DL7AD/pecanpico9/tracker/software/doc/2fsk.jpg

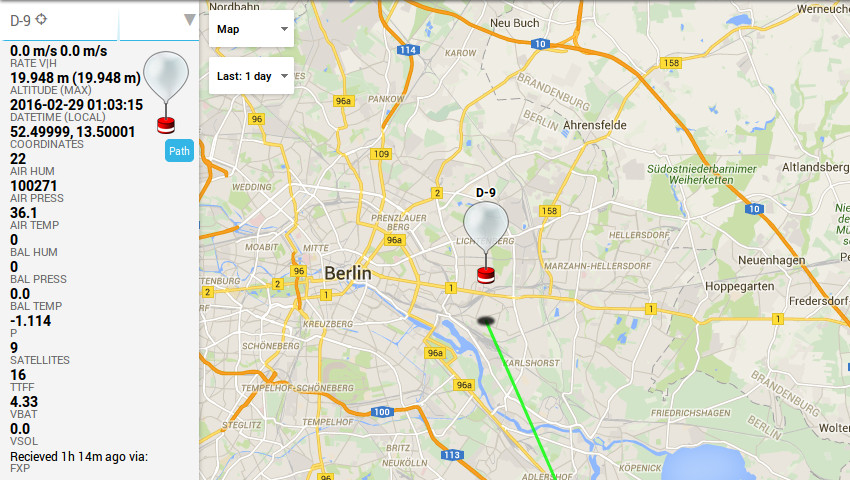
tracker/software/doc/2fsk.jpg
