DL7AD/pecanpico9/tracker/software/doc/aprs.jpg

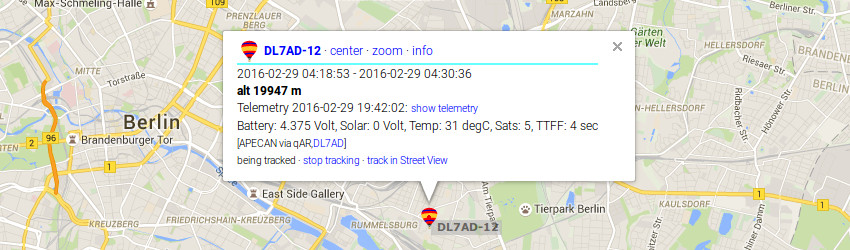
tracker/software/doc/aprs.jpg
