DL7AD/pecanpico9/tracker/software/doc/cw.jpg

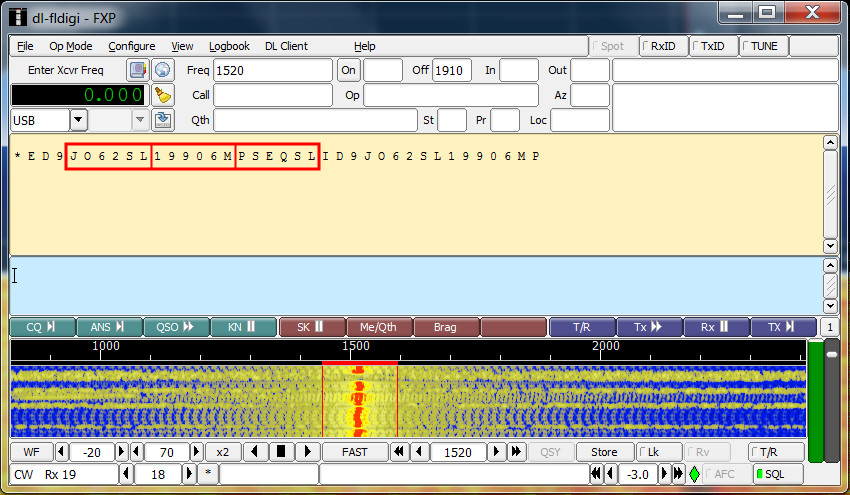
tracker/software/doc/cw.jpg
