DL7AD/pecanpico9/tracker/software/doc/programmer.jpg

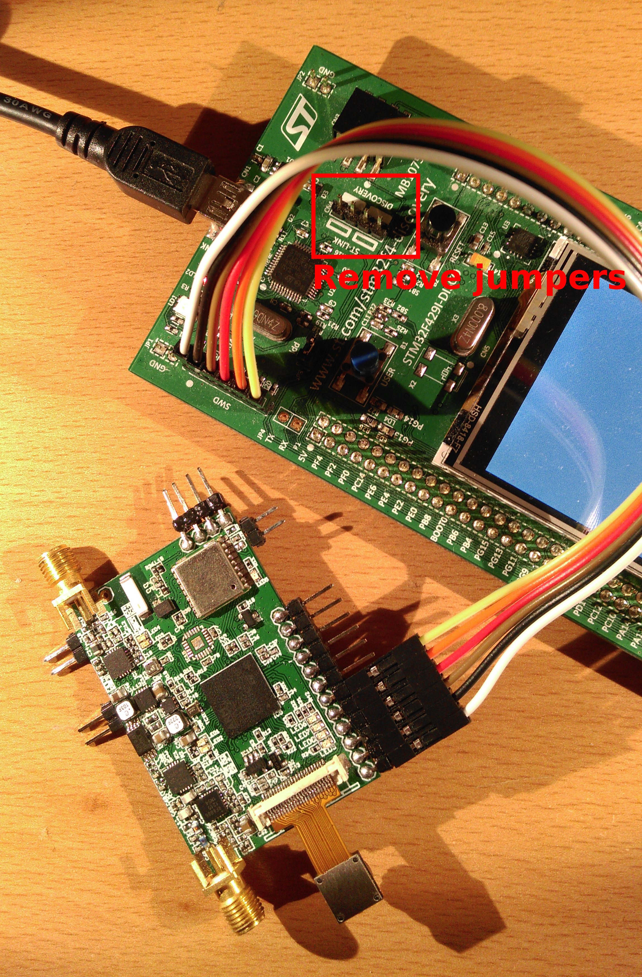
tracker/software/doc/programmer.jpg
