DL7AD/pecanpico9/tracker/software/doc/targets/pecanpico7a.jpg

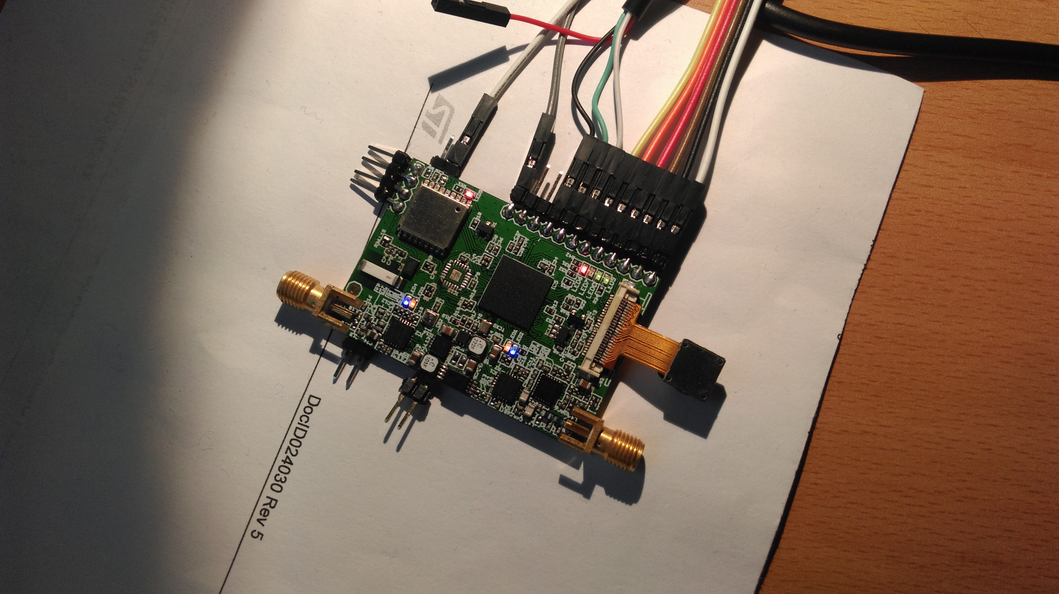
tracker/software/doc/targets/pecanpico7a.jpg
