DL7AD/pecanpico9/tracker/hardware/output/bom.ods

 |  |  |  |  |  |  | Prices roughly
Reference | Quantity | Package | Value | Specs | Mouser | Notes | Price | Price All
C48;C46;C45;C44;C43;C14;C30;C33;C20;C23;C29;C35 | 12 | C_0402 | 100n | 10V |  |  | 0.01 | 0.12
C32;C38 | 2 | C_0402 | 10n | 10V |  |  | 0.01 | 0.02
C40;C37;C39;C9;C8;C10;C11;C12;C13;C22;C51 | 11 | C_0402 | 2u2 | 10V |  |  | 0.03 | 0.33
R25;R26 | 2 | R_0402 | 4k7 | 1% |  |  | 0.01 | 0.02
R10;R11;R21;R35 | 4 | R_0402 | 1k5 | 1% |  |  | 0.01 | 0.04
D2 | 1 | LED_0603 | blue |  |  |  | 0.10 | 0.10
D3 | 1 | LED_0603 | green |  |  |  | 0.05 | 0.05
L2 | 1 | LPS3015 | LPS3015-222 |  | 994-LPS3015-222MRC |  | 1.03 | 1.03
R7 | 1 | R_0402 | 510k | 1% |  |  | 0.01 | 0.01
IC2 | 1 | DFN-6-1EP_2x2mm_Pitch0.65mm | TPS62260DRVR |  | 595-TPS62260DRVR |  | 1.35 | 1.35
R8;R36 | 2 | R_0402 | 249k | 1% |  |  | 0.01 | 0.02
C5;C26;C24 | 3 | C_0402 | 22p | 10V |  |  | 0.03 | 0.09
C6;C4;C3 | 3 | C_0805 | 10u | 10V |  |  | 0.10 | 0.30
X1 | 1 | tcxo | KT2016K26000BCW18ZAS |  | 581-KT2016K2BCW18ZAS |  | 1.77 | 1.77
IC1 | 1 | TSSOP-8_4.4x3mm_Pitch0.65mm | SPV1040T |  | 511-SPV1040T |  | 2.69 | 2.69
R3;R5;R33 | 3 | R_0402 | 22k | 1% |  |  | 0.01 | 0.03
R4;R6;R32 | 3 | R_0402 | 10k | 1% |  |  | 0.01 | 0.03
C2 | 1 | C_0402 | 1n | 16V |  |  | 0.01 | 0.01
R1 | 1 | R_0402 | 220k | 1% |  |  | 0.01 | 0.01
R2;R14;R24;R23;R17;R28;R31 | 7 | R_0402 | 100k | 1% |  |  | 0.01 | 0.07
L1 | 1 | XAL4040 | XAL4040-103 |  | 994-XAL4040-103MEC |  | 2.25 | 2.25
C1;C31 | 2 | C_0805 | 22u | 10V |  |  | 0.10 | 0.20
IC3 | 1 | QFN-16-1EP_3x3mm_Pitch0.5mm | ADP322ACPZ-115-R7 |  | 584-ADP322ACPZ-115R7 |  | 1.37 | 1.37
IC4 | 1 | QFN-20-1EP_4x4mm_Pitch0.5mm | Si4063-B1B-FM |  | 634-SI4063-B1B-FM |  | 2.01 | 2.01
C15;C16;C34 | 3 | C_0402 | 100p | 10V |  |  | 0.01 | 0.03
C18;C19;C25;C27 | 4 | C_0402 | 470p | 16V |  |  | 0.01 | 0.04
L3 | 1 | C_0805 | 470n |  | 994-0805LS-471XJLB |  | 1.35 | 1.35
P3 | 1 | USB_Micro-B_SMD | ZX62-B-5PA(33) |  | 798-ZX62-B-5PA33 |  | 0.58 | 0.58
IC6 | 1 | EVA7M | EVA-7M |  |  | get from uBlox directly | 15.00 | 15.00
R19;R20;R13 | 3 | R_0402 | N/A |  |  | do not assemble | 0.01 | 0.03
D7 | 1 | LED_0603 | red |  |  |  | 0.05 | 0.05
R22;R18 | 2 | R_0603 | 0R1 |  | 667-ERJ-3RSFR10V |  | 0.01 | 0.02
IC7 | 1 | DFN-10-1EP_3x3mm_Pitch0.5mm | PAC1720-1-AIA-TR |  | 579-PAC1720-1-AIA-TR |  | 1.63 | 1.63
R27 | 1 | R_0402 | 0R |  |  |  | 0.01 | 0.01
P4;P6 | 2 | IPX_2mm | IPX 2mm |  | 960-RECE20279001E01 |  | 0.87 | 1.74
D9;D8 | 2 | RFN1L7S | RFN1L7STE25 |  | 755-RFN1L7STE25 |  | 0.31 | 0.62
R29;R30 | 2 | R_0402 | 1k | 1% |  |  | 0.01 | 0.02
C28 | 1 | C_0402 | 1u | 10V |  |  | 0.02 | 0.02
Q1 | 1 | SOT-23 | FDN306P |  | 512-FDN306P |  | 0.37 | 0.37
W8;W6;W10 | 3 | PAD_6x3 | Pad |  |  | do not assemble | 0.00 | 0.00
W7;W11 | 2 | PAD_3x3 | Pad |  |  | do not assemble | 0.00 | 0.00
P5 | 1 | Pin_Header_Straight_1x02_SMD | CONN_01X02 |  |  | do not assemble | 0.00 | 0.00
L4;L6 | 2 | C_0805 | 56n |  | 994-0805CS-560XJLC |  | 0.94 | 1.88
IC9 | 1 | BME280 | BME280 |  | 262-BME280 |  | 6.53 | 6.53
L5 | 1 | C_0805 | 82n |  | 994-0805CS-820XJLC |  | 0.94 | 0.94
W1;W2;W3;W9 | 4 | PAD_3x1.5 | Testpad |  |  | do not assemble | 0.00 | 0.00
IC8 | 1 | DFN-6-1EP_2x2mm_Pitch0.5mm | LDLN015PU33R |  | 511-LDLN015PU33R |  | 1.25 | 1.25
IC5 | 1 | LQFP-64_10x10mm_Pitch0.5mm | STM32F413xG |  | 511-STM32F413RGT6 |  | 8.75 | 8.75
P2 | 1 | Pin_Header_Straight_1x10 | CONN_01X10 |  |  | do not assemble | 0.00 | 0.00
P1 | 1 | FFC1x24_0.5mm (+camera) | CONN_01X25 |  |  |  | 6.00 | 6.00
W5;W4 | 2 | Testpad | Testpad |  |  | do not assemble | 0.00 | 0.00
PCB | 1 |  |  |  |  |  | 3.00 | 3.00
Assembly | 1 |  |  |  |  |  | 20.00 | 20.00
 |  |  |  |  |  |  |  | 83.78
