DL7AD/pecanpico9/tracker/software/doc/sample_pictures/test1.jpg

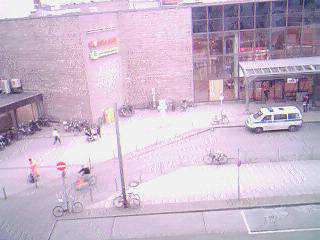
tracker/software/doc/sample_pictures/test1.jpg
