DL7AD/pecanpico9/tracker/software/doc/sample_pictures/test3.jpg

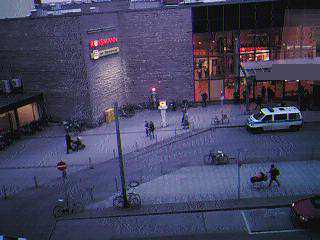
tracker/software/doc/sample_pictures/test3.jpg
