DL7AD/pecanpico9/tracker/software/doc/sample_pictures/test4.jpg

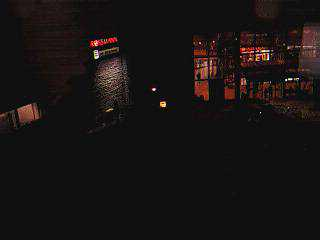
tracker/software/doc/sample_pictures/test4.jpg
