DL7AD/pecanpico9/tracker/hardware/pecanpico9.kicad_pcb

## KiCad design tracker/hardware/pecanpico9.kicad_pcb (2017-06-15)

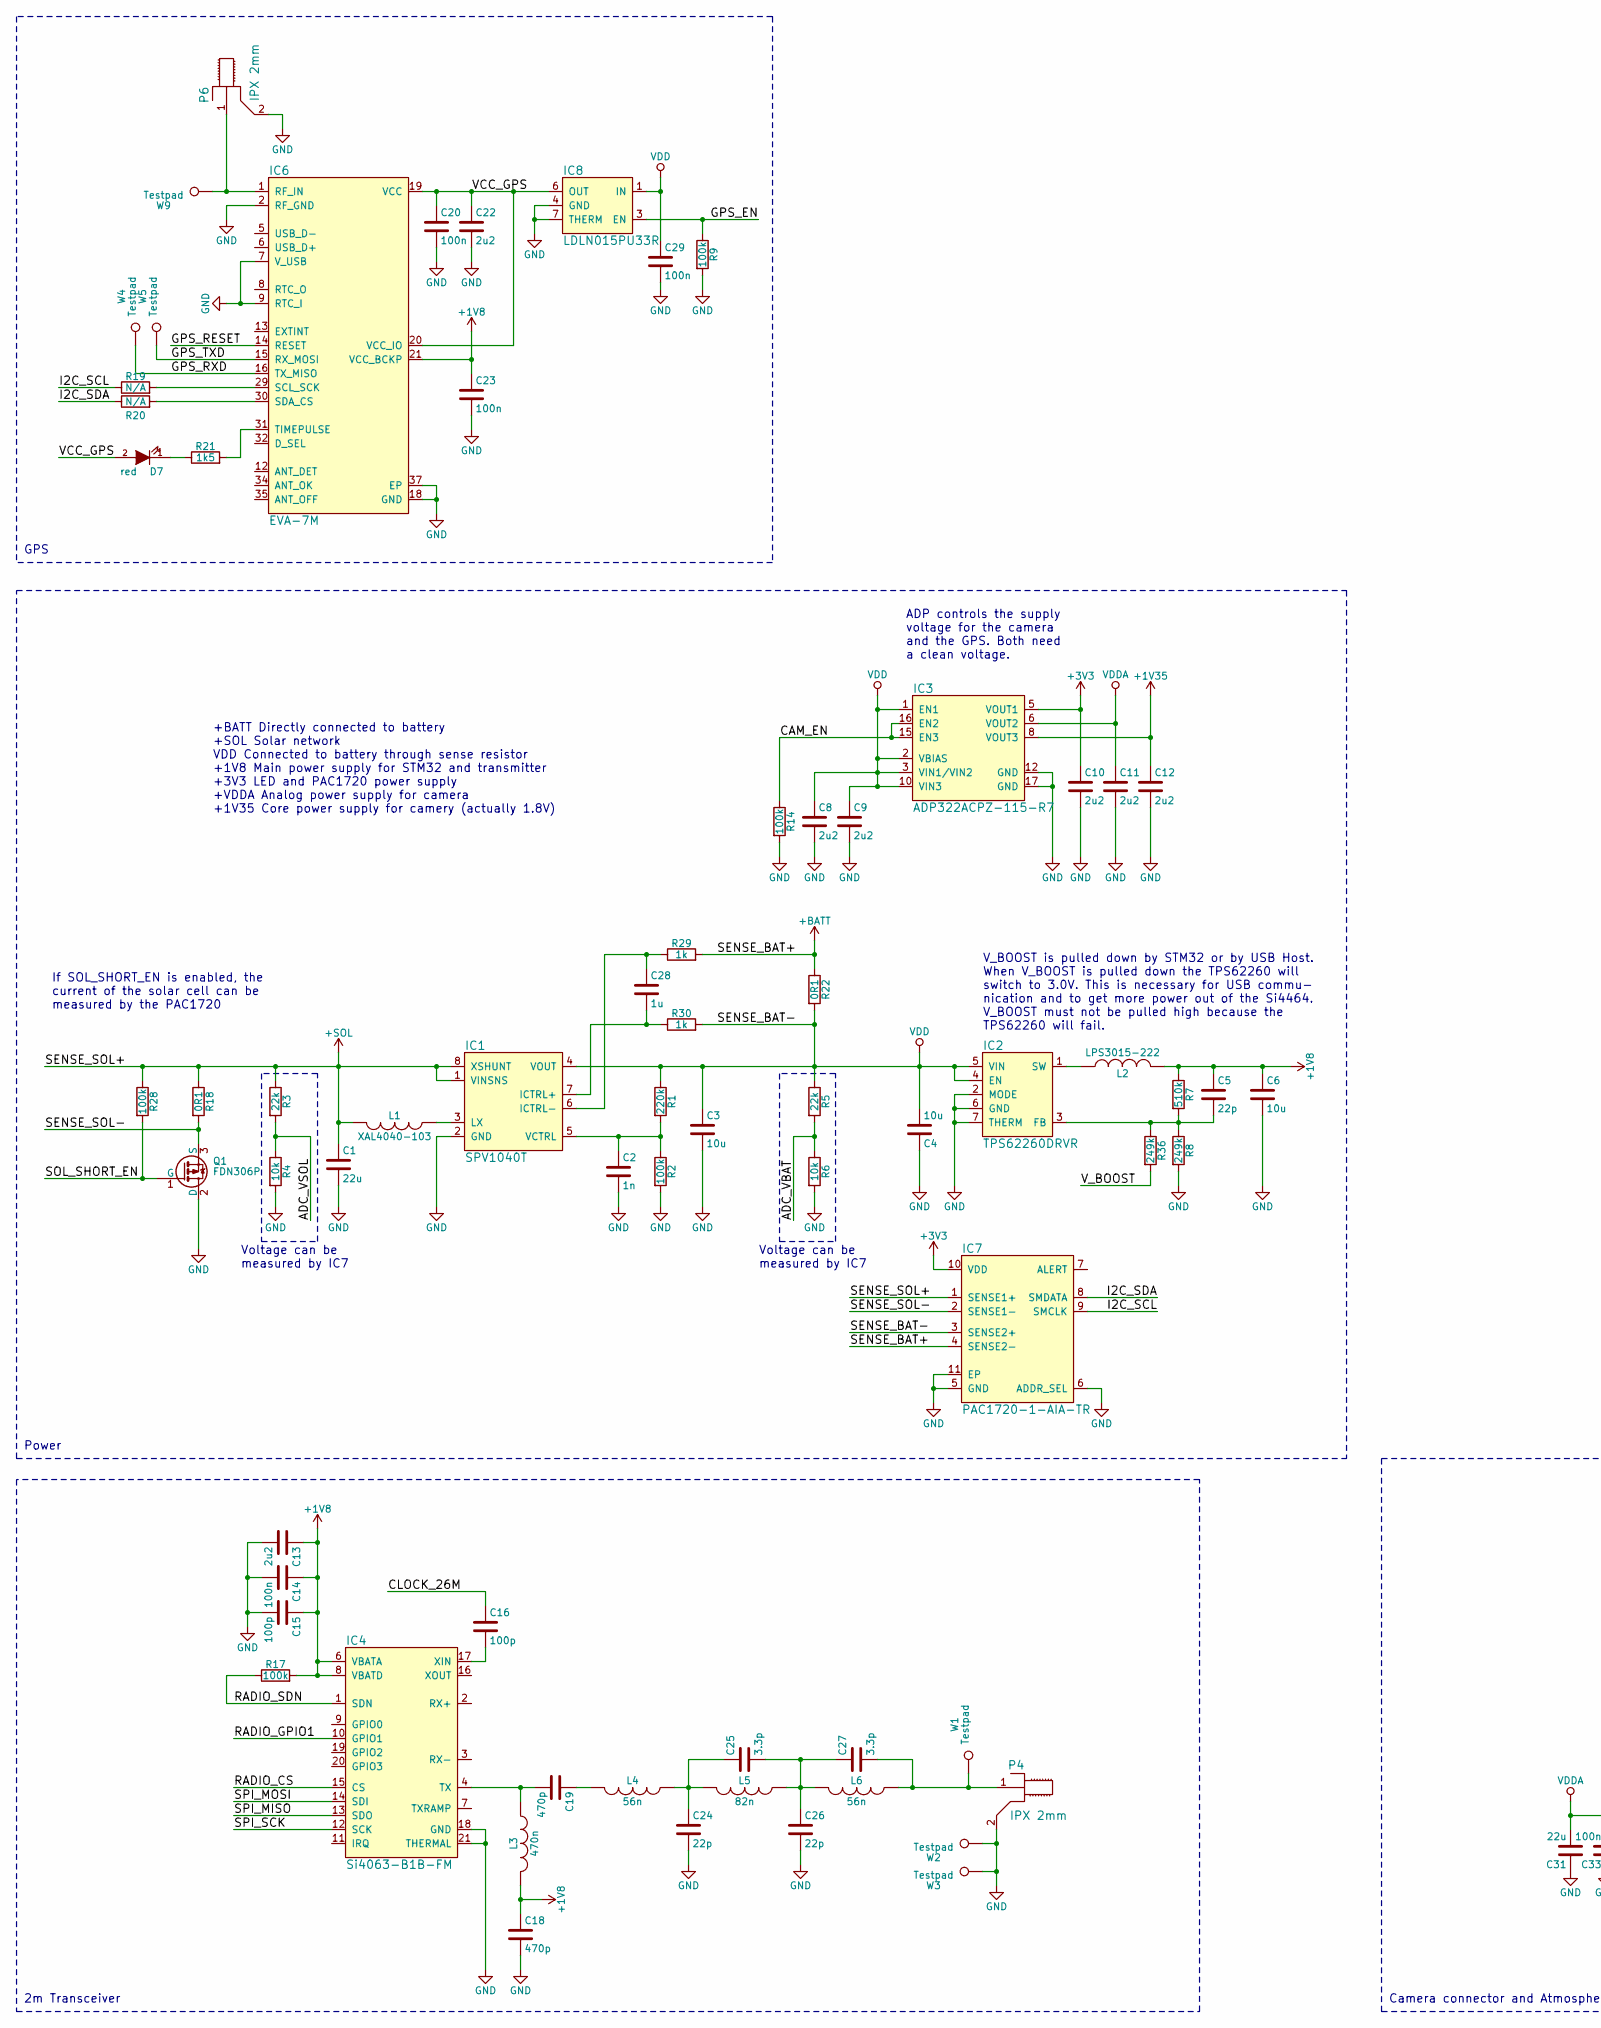
[picture p30: schematic pecanpico9.sch, Pecan Pico 9a, part in row 1, column 1]

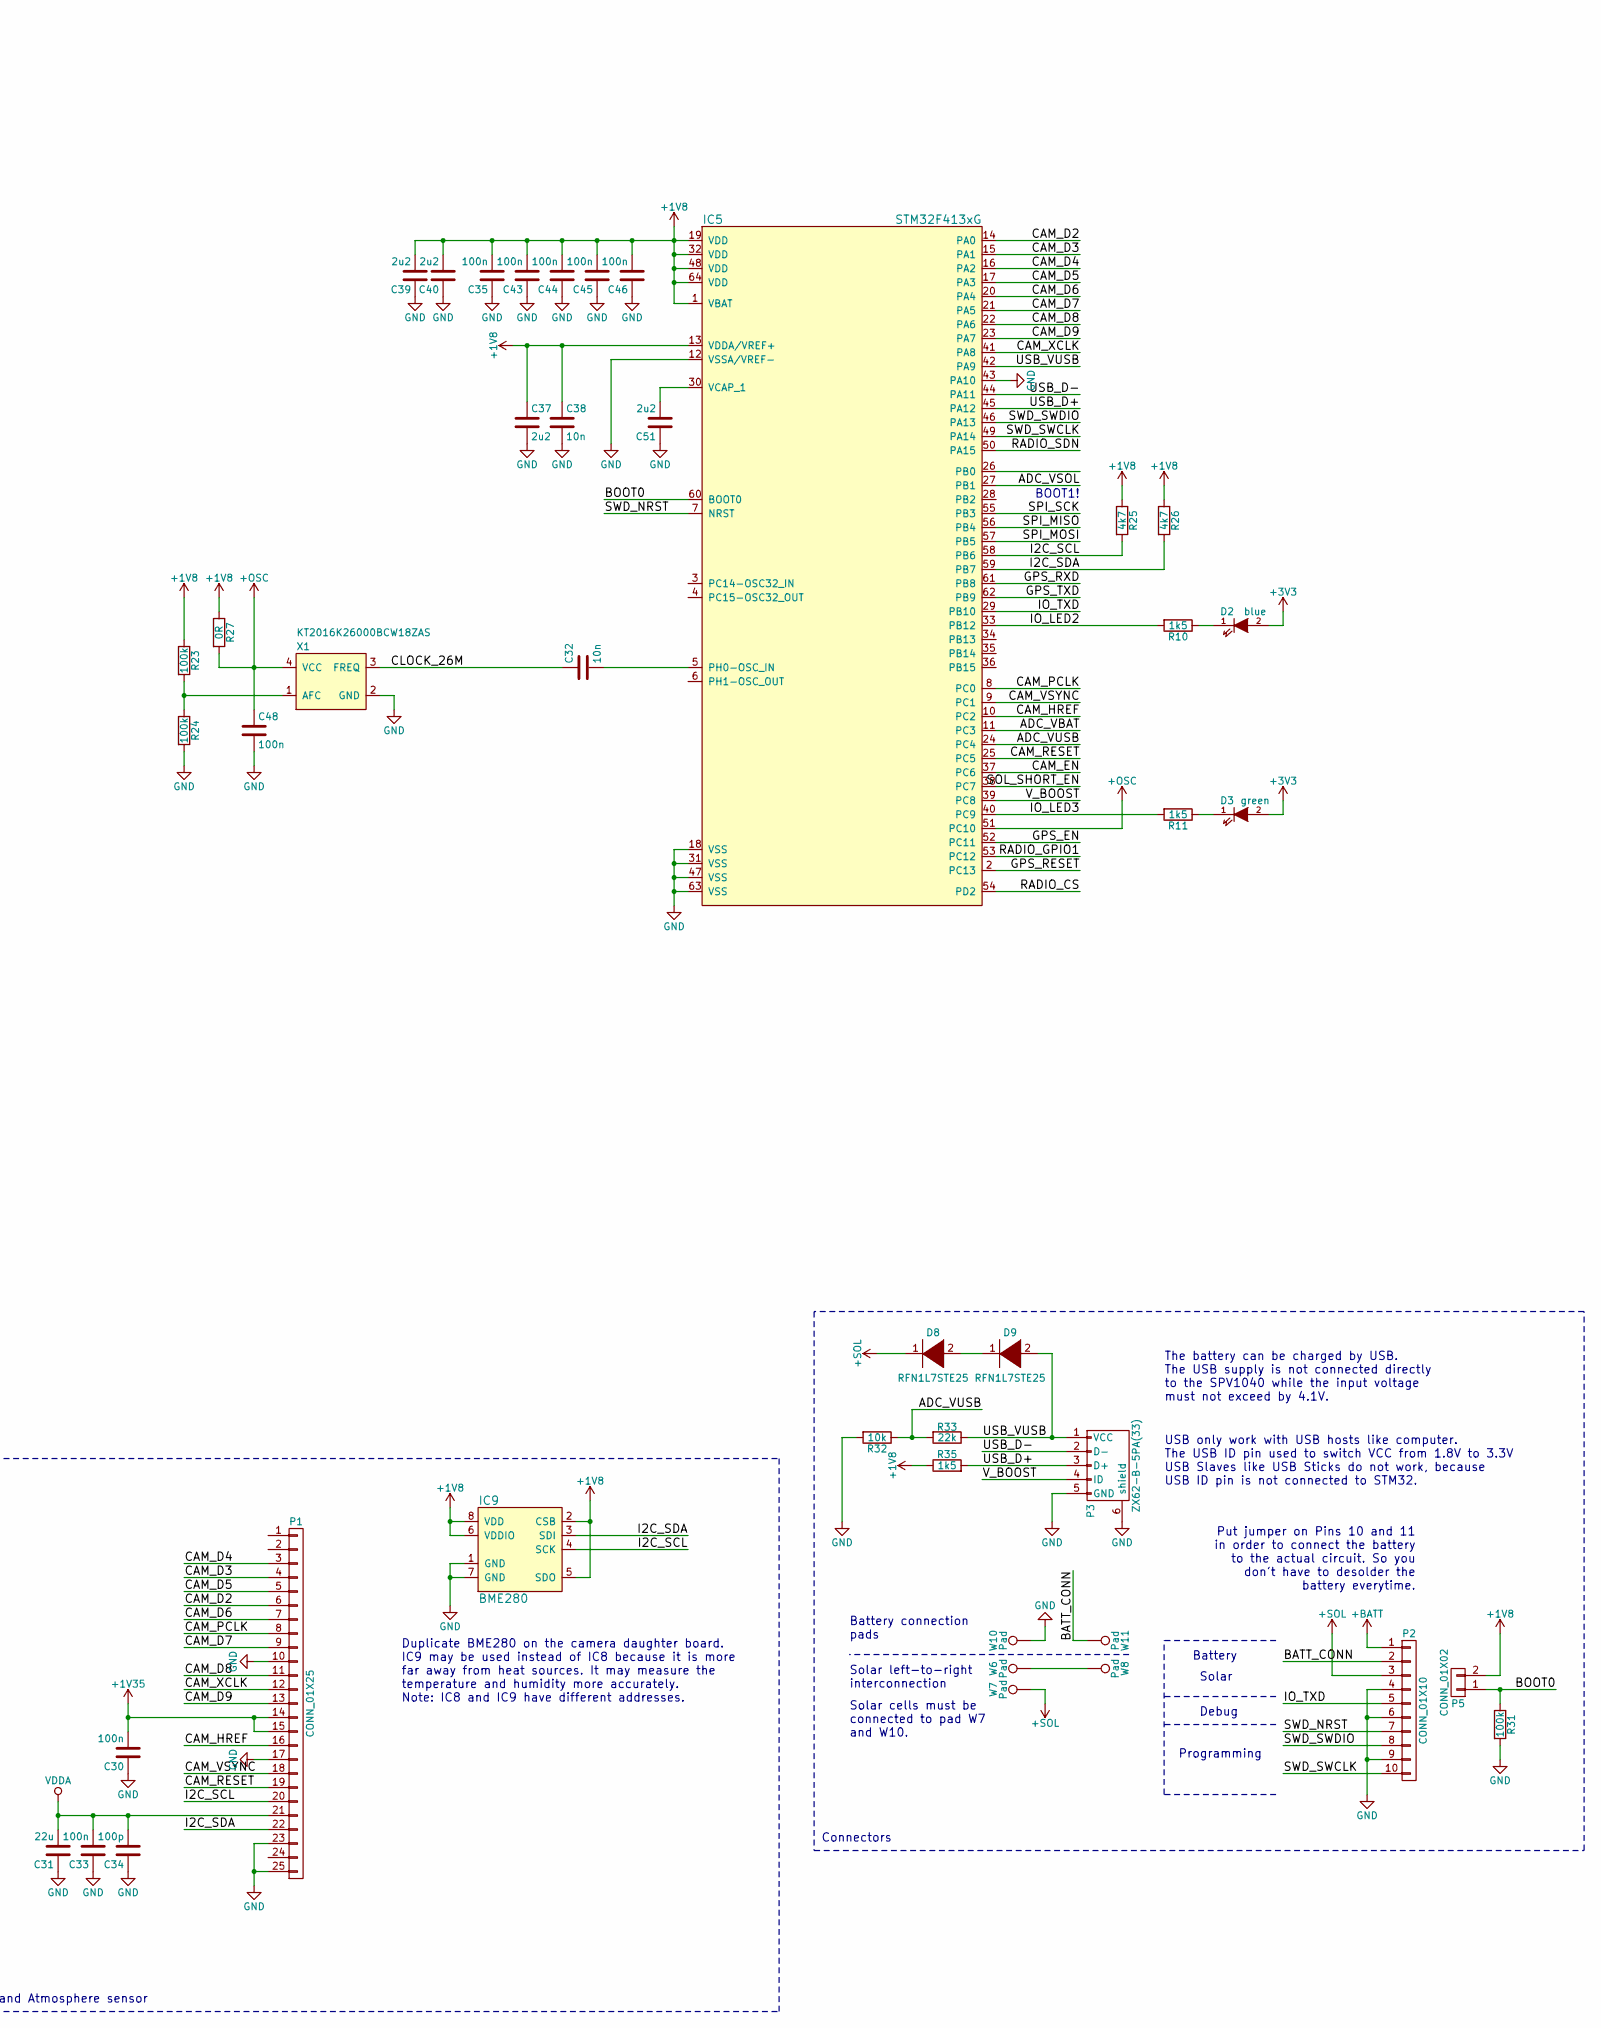
[picture p31: schematic pecanpico9.sch, Pecan Pico 9a, part in row 1, column 2]

Parts:
C1, C31: 22u; C_0805
C2: 1n; C_0402
C3, C4, C6: 10u; C_0805
C5, C24, C26: 22p; C_0402
C8, C9, C10, C11, C12, C13, C22, C37, C39, C40, C51: 2u2; C_0402
C14, C20, C23, C29, C30, C33, C35, C43, C44, C45, C46, C48: 100n; C_0402
C15, C16, C34: 100p; C_0402
C18, C19: 470p; C_0402
C25, C27: 3.3p; C_0402
C28: 1u; C_0402
C32, C38: 10n; C_0402
D2: blue; LED_0603
D3: green; LED_0603
D7: red; LED_0603
D8, D9: RFN1L7STE25; RFN1L7S; Mouser 755-RFN1L7STE25
IC1: SPV1040T; TSSOP-8_4.4x3mm_Pitch0.65mm; Mouser 511-SPV1040T
IC2: TPS62260DRVR; DFN-6-1EP_2x2mm_Pitch0.65mm; Mouser 595-TPS62260DRVR
IC3: ADP322ACPZ-115-R7; QFN-16-1EP_3x3mm_Pitch0.5mm; Mouser 584-ADP322ACPZ-115R7
IC4: Si4063-B1B-FM; QFN-20-1EP_4x4mm_Pitch0.5mm; Mouser 634-SI4063-B1B-FM
IC5: STM32F413xG; LQFP-64_10x10mm_Pitch0.5mm
IC6: EVA-7M; EVA7M
IC7: PAC1720-1-AIA-TR; DFN-10-1EP_3x3mm_Pitch0.5mm; Mouser 579-PAC1720-1-AIA-TR
IC8: LDLN015PU33R; DFN-6-1EP_2x2mm_Pitch0.5mm; Mouser 511-LDLN015PU33R
IC9: BME280; Mouser 262-BME280
L1: XAL4040-103; XAL4040; Mouser 994-XAL4040-103MEC
L2: LPS3015-222; LPS3015; Mouser 994-LPS3015-222MRC
L3: 470n; C_0805; Mouser 994-0805LS-471XJLB
L4, L6: 56n; C_0805; Mouser 994-0805CS-560XJLC
L5: 82n; C_0805; Mouser 994-0805CS-820XJLC
P1: CONN_01X25; FFC1x24_0.5mm
P2: CONN_01X10; Pin_Header_Straight_1x10
P3: ZX62-B-5PA(33); USB_Micro-B_SMD; Mouser 798-ZX62-B-5PA33
P4, P6: IPX 2mm; IPX_2mm; Mouser 960-RECE20279001E01
P5: CONN_01X02; Pin_Header_Straight_1x02_SMD
Q1: FDN306P; SOT-23; Mouser 512-FDN306P
R1: 220k; R_0402
R2, R9, R14, R17, R23, R24, R28, R31: 100k; R_0402
R3, R5, R33: 22k; R_0402
R4, R6, R32: 10k; R_0402
R7: 510k; R_0402
R8, R36: 249k; R_0402
R10, R11, R21, R35: 1k5; R_0402
R18, R22: 0R1; R_0603; Mouser 667-ERJ-3RSFR10V
R19, R20: N/A; R_0402
R25, R26: 4k7; R_0402
R27: 0R; R_0402
R29, R30: 1k; R_0402
W1, W2, W3, W9: Testpad; PAD_3x1.5
W4, W5: Testpad
W6, W8, W10: Pad; PAD_6x3
W7, W11: Pad; PAD_3x3
X1: KT2016K26000BCW18ZAS; tcxo; Mouser 581-KT2016K2BCW18ZAS

Connections:
+1V8: C5.1, C6.1, C13.1, C14.1, C15.1, C18.1, C23.1, C35.2, C37.1, C38.1, C39.2, C40.2, C43.2, C44.2, C45.2, C46.2, IC4.6 (VBATA), IC4.8 (VBATD), IC5.1 (VBAT), IC5.13 (VDDA/VREF+), IC5.19 (VDD), IC5.32 (VDD), IC5.48 (VDD), IC5.64 (VDD), IC6.21 (VCC_BCKP), IC9.2 (CSB), IC9.5 (SDO), IC9.6 (VDDIO), IC9.8 (VDD), L2.2, L3.2, P5.2, R7.1, R17.2, R23.1, R25.1, R26.1, R27.1, R35.1
+1V35: C12.1, C30.2, IC3.8 (VOUT3), P1.14, P1.15
+3V3: C10.1, D2.2 (A), D3.2 (A), IC3.5 (VOUT1), IC7.10 (VDD)
+BATT: IC7.4 (SENSE2-), P2.1, R22.1, R29.2
+OSC: C48.1, IC5.51 (PC10), R27.2, X1.4 (VCC)
+SOL: C1.1, D8.1 (K), IC1.1 (VINSNS), IC1.8 (XSHUNT), IC7.1 (SENSE1+), L1.2, P2.3, R3.1, R18.1, R28.1, W7.1
/ADC_VBAT: IC5.11 (PC3), R5.2, R6.1
/ADC_VSOL: IC5.27 (PB1), R3.2, R4.1
/ADC_VUSB: IC5.24 (PC4), R32.1, R33.2
/BATT_CONN: P2.2, W11.1
/BOOT0: IC5.60 (BOOT0), P5.1, R31.1
/CAM_D2: IC5.14 (PA0), P1.6
/CAM_D3: IC5.15 (PA1), P1.4
/CAM_D4: IC5.16 (PA2), P1.3
/CAM_D5: IC5.17 (PA3), P1.5
/CAM_D6: IC5.20 (PA4), P1.7
/CAM_D7: IC5.21 (PA5), P1.9
/CAM_D8: IC5.22 (PA6), P1.11
/CAM_D9: IC5.23 (PA7), P1.13
/CAM_EN: IC3.15 (EN3), IC3.16 (EN2), IC5.37 (PC6), R14.1
/CAM_HREF: IC5.10 (PC2), P1.16
/CAM_PCLK: IC5.8 (PC0), P1.8
/CAM_RESET: IC5.25 (PC5), P1.19
/CAM_VSYNC: IC5.9 (PC1), P1.18
/CAM_XCLK: IC5.41 (PA8), P1.12
/CLOCK_26M: C16.1, C32.1, X1.3 (FREQ)
/GPS_EN: IC5.52 (PC11), IC8.3 (EN), R9.1
/GPS_RESET: IC5.2 (PC13), IC6.14 (RESET)
/GPS_RXD: IC5.61 (PB8), IC6.16 (TX_MISO), W4.1
/GPS_TXD: IC5.62 (PB9), IC6.15 (RX_MOSI), W5.1
/I2C_SCL: IC5.58 (PB6), IC7.9 (SMCLK), IC9.4 (SCK), P1.20, R19.1, R25.2
/I2C_SDA: IC5.59 (PB7), IC7.8 (SMDATA), IC9.3 (SDI), P1.22, R20.1, R26.2
/IO_LED2: IC5.33 (PB12), R10.2
/IO_LED3: IC5.40 (PC9), R11.2
/IO_TXD: IC5.29 (PB10), P2.5
/RADIO_CS: IC4.15 (CS), IC5.54 (PD2)
/RADIO_GPIO1: IC4.10 (GPIO1), IC5.53 (PC12)
/RADIO_SDN: IC4.1 (SDN), IC5.50 (PA15), R17.1
/SENSE_SOL-: IC7.2 (SENSE1-), Q1.3 (S), R18.2
/SOL_SHORT_EN: IC5.38 (PC7), Q1.1 (G), R28.2
/SPI_MISO: IC4.13 (SDO), IC5.56 (PB4)
/SPI_MOSI: IC4.14 (SDI), IC5.57 (PB5)
/SPI_SCK: IC4.12 (SCK), IC5.55 (PB3)
/SWD_NRST: IC5.7 (NRST), P2.7
/SWD_SWCLK: IC5.49 (PA14), P2.10
/SWD_SWDIO: IC5.46 (PA13), P2.8
/USB_D+: IC5.45 (PA12), P3.3 (D+), R35.2
/USB_D-: IC5.44 (PA11), P3.2 (D-)
/USB_VUSB: D9.2 (A), IC5.42 (PA9), P3.1 (VCC), R33.1
/VCC_GPS: C20.1, C22.1, D7.2 (A), IC6.19 (VCC), IC6.20 (VCC_IO), IC8.6 (OUT)
/V_BOOST: IC5.39 (PC8), P3.4 (ID), R36.2
GND: C1.2, C2.2, C3.2, C4.1, C6.2, C8.2, C9.2, C10.2, C11.2, C12.2, C13.2, C14.2, C15.2, C18.2, C20.2, C22.2, C23.2, C24.2, C26.2, C29.2, C30.1, C31.1, C33.1, C34.1, C35.1, C37.2, C38.2, C39.1, C40.1, C43.1, C44.1, C45.1, C46.1, C48.2, C51.1, IC1.2 (GND), IC2.2 (MODE), IC2.6 (GND), IC2.7 (THERM), IC3.12 (GND), IC3.17 (GND), IC4.18 (GND), IC4.21 (THERMAL), IC5.12 (VSSA/VREF-), IC5.18 (VSS), IC5.31 (VSS), IC5.43 (PA10), IC5.47 (VSS), IC5.63 (VSS), IC6.2 (RF_GND), IC6.7 (V_USB), IC6.9 (RTC_I), IC6.18 (GND), IC6.37 (EP), IC7.5 (GND), IC7.6 (ADDR_SEL), IC7.11 (EP), IC8.4 (GND), IC8.7 (THERM), IC9.1 (GND), IC9.7 (GND), P1.10, P1.17, P1.23, P1.25, P2.4, P2.6, P2.9, P3.5 (GND), P3.6 (shield), P4.2, P6.2, Q1.2 (D), R2.2, R4.2, R6.2, R8.2, R9.2, R14.2, R24.2, R31.2, R32.2, W2.1, W3.1, W10.1, X1.2 (GND)
unnamed: C2.1, IC1.5 (VCTRL), R1.2, R2.1
unnamed: C5.2, IC2.3 (FB), R7.2, R8.1, R36.1
unnamed: C16.2, IC4.17 (XIN)
unnamed: C19.1, L4.2
unnamed: C19.2, IC4.4 (TX), L3.1
unnamed: C24.1, C25.1, L4.1, L5.2
unnamed: C25.2, C26.1, C27.1, L5.1, L6.2
unnamed: C27.2, L6.1, P4.1, W1.1
unnamed: C28.1, IC1.6 (ICTRL-), R29.1
unnamed: C28.2, IC1.7 (ICTRL+), R30.1
unnamed: C32.2, IC5.5 (PH0-OSC_IN)
unnamed: C51.2, IC5.30 (VCAP_1)
unnamed: D2.1 (K), R10.1
unnamed: D3.1 (K), R11.1
unnamed: D7.1 (K), R21.1
unnamed: D8.2 (A), D9.1 (K)
unnamed: IC1.3 (LX), L1.1
unnamed: IC2.1 (SW), L2.1
unnamed: IC6.1 (RF_IN), P6.1, W9.1
unnamed: IC6.29 (SCL_SCK), R19.2
unnamed: IC6.30 (SDA_CS), R20.2
unnamed: IC6.31 (TIMEPULSE), R21.2
unnamed: R23.2, R24.1, X1.1 (AFC)
unnamed: W6.1, W8.1
VDD: C3.1, C4.2, C8.1, C9.1, C29.1, IC1.4 (VOUT), IC2.4 (EN), IC2.5 (VIN), IC3.1 (EN1), IC3.2 (VBIAS), IC3.3 (VIN1/VIN2), IC3.10 (VIN3), IC7.3 (SENSE2+), IC8.1 (IN), R1.1, R5.1, R22.2, R30.2
VDDA: C11.1, C31.2, C33.2, C34.2, IC3.6 (VOUT2), P1.21

Notes on the sheet:
USB only work with USB hosts like computer. The USB ID pin used to switch VCC from 1.8V to 3.3V USB Slaves like USB Sticks do not work, because USB ID pin is not connected to STM32.
Voltage can be measured by IC7
Duplicate BME280 on the camera daughter board. IC9 may be used instead of IC8 because it is more far away from heat sources. It may measure the temperature and humidity more accurately. Note: IC8 and IC9 have different addresses.
V_BOOST is pulled down by STM32 or by USB Host. When V_BOOST is pulled down the TPS62260 will switch to 3.0V. This is necessary for USB commu- nication and to get more power out of the Si4464. V_BOOST must not be pulled high because the TPS62260 will fail.
ADP controls the supply voltage for the camera and the GPS. Both need a clean voltage.
Put jumper on Pins 10 and 11 in order to connect the battery to the actual circuit. So you don't have to desolder the battery everytime.
Battery
Solar
Debug
Programming
Battery connection pads
Solar left-to-right interconnection
Solar cells must be connected to pad W7 and W10.
The battery can be charged by USB. The USB supply is not connected directly to the SPV1040 while the input voltage must not exceed by 4.1V.
Camera connector and Atmosphere sensor
2m Transceiver
Power
GPS
Connectors
+BATT Directly connected to battery +SOL Solar network VDD Connected to battery through sense resistor +1V8 Main power supply for STM32 and transmitter +3V3 LED and PAC1720 power supply +VDDA Analog power supply for camera +1V35 Core power supply for camery (actually 1.8V)
If SOL_SHORT_EN is enabled, the current of the solar cell can be measured by the PAC1720
BOOT1!

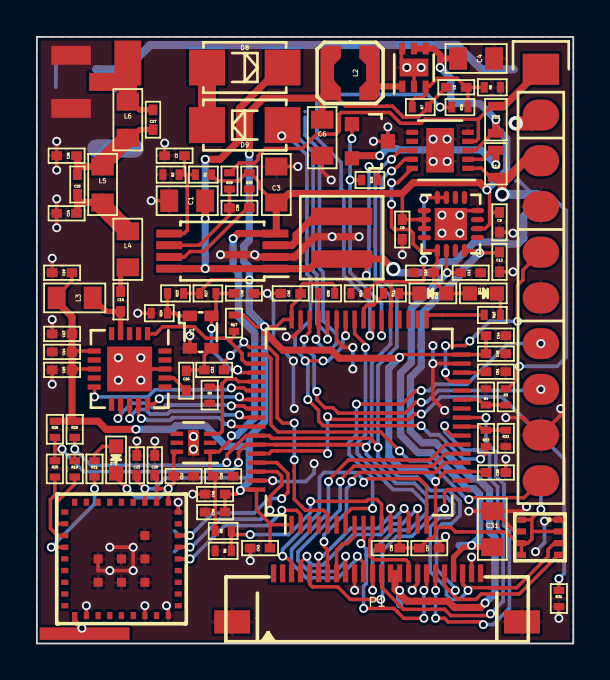
[picture p32: board pecanpico9.kicad_pcb from above]

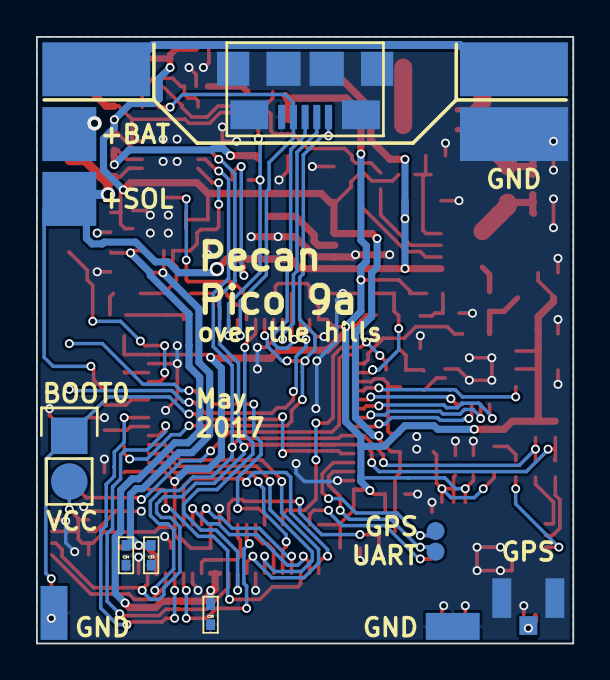
[picture p33: board pecanpico9.kicad_pcb from below]

Board: 2 copper layers, 29.8 x 33.7 mm, 112 parts (15 on the bottom side), 78 nets.
