DL7AD/pecanpico9/tracker/software/board/board.h

/*
    ChibiOS - Copyright (C) 2006..2016 Giovanni Di Sirio

    Licensed under the Apache License, Version 2.0 (the "License");
    you may not use this file except in compliance with the License.
    You may obtain a copy of the License at

        http://www.apache.org/licenses/LICENSE-2.0

    Unless required by applicable law or agreed to in writing, software
    distributed under the License is distributed on an "AS IS" BASIS,
    WITHOUT WARRANTIES OR CONDITIONS OF ANY KIND, either express or implied.
    See the License for the specific language governing permissions and
    limitations under the License.
*/

#ifndef _BOARD_H_
#define _BOARD_H_

/*
 * Setup for Pecan Pico 9a board.
 */

/*
 * Board identifier.
 */
#define BOARD_PECANPICO9A
#define BOARD_NAME                  "Pecan Pico 9a"

/*
 * No LSE available
 */
#if !defined(STM32_LSECLK)
#define STM32_LSECLK                0U
#endif

#if !defined(STM32_HSECLK)
#define STM32_HSECLK                26000000U
#endif

/*
 * Board voltages
 * Required for performance limits calculation
 */
#define STM32_VDD                   180U

/*
 * MCU type as defined in the ST header
 */
#define STM32F413xx

/*
 * Radio specifications
 */
#define RADIO_MIN_FREQ				144000000
#define RADIO_MAX_FREQ				148000000
#define RADIO_CLK					STM32_HSECLK

/*
 * IO pins assignments.
 */
#define GPIOA_PIN0                  0U
#define GPIOA_PIN1                  1U
#define GPIOA_PIN2                  2U
#define GPIOA_PIN3                  3U
#define GPIOA_PIN4                  4U
#define GPIOA_PIN5                  5U
#define GPIOA_PIN6                  6U
#define GPIOA_PIN7                  7U
#define GPIOA_PIN8                  8U
#define GPIOA_USB_VBUS              9U
#define GPIOA_USB_ID                10U
#define GPIOA_USB_DM                11U
#define GPIOA_USB_DP                12U
#define GPIOA_SWDIO                 13U
#define GPIOA_SWCLK                 14U
#define GPIOA_PIN15                 15U

#define GPIOB_PIN0                  0U
#define GPIOB_PIN1                  1U
#define GPIOB_PIN2                  2U
#define GPIOB_PIN3                  3U
#define GPIOB_PIN4                  4U
#define GPIOB_PIN5                  5U
#define GPIOB_PIN6                  6U
#define GPIOB_PIN7                  7U
#define GPIOB_PIN8                  8U
#define GPIOB_PIN9                  9U
#define GPIOB_PIN10                 10U
#define GPIOB_PIN11                 11U
#define GPIOB_PIN12                 12U
#define GPIOB_PIN13                 13U
#define GPIOB_PIN14                 14U
#define GPIOB_PIN15                 15U

#define GPIOC_PIN0                  0U
#define GPIOC_PIN1                  1U
#define GPIOC_PIN2                  2U
#define GPIOC_PIN3                  3U
#define GPIOC_PIN4                  4U
#define GPIOC_PIN5                  5U
#define GPIOC_PIN6                  6U
#define GPIOC_PIN7                  7U
#define GPIOC_PIN8                  8U
#define GPIOC_PIN9                  9U
#define GPIOC_PIN10                 10U
#define GPIOC_PIN11                 11U
#define GPIOC_PIN12                 12U
#define GPIOC_PIN13                 13U
#define GPIOC_OSC32_IN              14U
#define GPIOC_OSC32_OUT             15U

#define GPIOD_PIN0                  0U
#define GPIOD_PIN1                  1U
#define GPIOD_PIN2                  2U
#define GPIOD_PIN3                  3U
#define GPIOD_PIN4                  4U
#define GPIOD_PIN5                  5U
#define GPIOD_PIN6                  6U
#define GPIOD_PIN7                  7U
#define GPIOD_PIN8                  8U
#define GPIOD_PIN9                  9U
#define GPIOD_PIN10                 10U
#define GPIOD_PIN11                 11U
#define GPIOD_PIN12                 12U
#define GPIOD_PIN13                 13U
#define GPIOD_PIN14                 14U
#define GPIOD_PIN15                 15U

#define GPIOE_PIN0                  0U
#define GPIOE_PIN1                  1U
#define GPIOE_PIN2                  2U
#define GPIOE_PIN3                  3U
#define GPIOE_PIN4                  4U
#define GPIOE_PIN5                  5U
#define GPIOE_PIN6                  6U
#define GPIOE_PIN7                  7U
#define GPIOE_PIN8                  8U
#define GPIOE_PIN9                  9U
#define GPIOE_PIN10                 10U
#define GPIOE_PIN11                 11U
#define GPIOE_PIN12                 12U
#define GPIOE_PIN13                 13U
#define GPIOE_PIN14                 14U
#define GPIOE_PIN15                 15U

#define GPIOF_PIN0                  0U
#define GPIOF_PIN1                  1U
#define GPIOF_PIN2                  2U
#define GPIOF_PIN3                  3U
#define GPIOF_PIN4                  4U
#define GPIOF_PIN5                  5U
#define GPIOF_PIN6                  6U
#define GPIOF_PIN7                  7U
#define GPIOF_PIN8                  8U
#define GPIOF_PIN9                  9U
#define GPIOF_PIN10                 10U
#define GPIOF_PIN11                 11U
#define GPIOF_PIN12                 12U
#define GPIOF_PIN13                 13U
#define GPIOF_PIN14                 14U
#define GPIOF_PIN15                 15U

#define GPIOG_PIN0                  0U
#define GPIOG_PIN1                  1U
#define GPIOG_PIN2                  2U
#define GPIOG_PIN3                  3U
#define GPIOG_PIN4                  4U
#define GPIOG_PIN5                  5U
#define GPIOG_PIN6                  6U
#define GPIOG_PIN7                  7U
#define GPIOG_PIN8                  8U
#define GPIOG_PIN9                  9U
#define GPIOG_PIN10                 10U
#define GPIOG_PIN11                 11U
#define GPIOG_PIN12                 12U
#define GPIOG_PIN13                 13U
#define GPIOG_PIN14                 14U
#define GPIOG_PIN15                 15U

#define GPIOH_OSC_IN                0U
#define GPIOH_OSC_OUT               1U
#define GPIOH_PIN2                  2U
#define GPIOH_PIN3                  3U
#define GPIOH_PIN4                  4U
#define GPIOH_PIN5                  5U
#define GPIOH_PIN6                  6U
#define GPIOH_PIN7                  7U
#define GPIOH_PIN8                  8U
#define GPIOH_PIN9                  9U
#define GPIOH_PIN10                 10U
#define GPIOH_PIN11                 11U
#define GPIOH_PIN12                 12U
#define GPIOH_PIN13                 13U
#define GPIOH_PIN14                 14U
#define GPIOH_PIN15                 15U

#define GPIOI_PIN0                  0U
#define GPIOI_PIN1                  1U
#define GPIOI_PIN2                  2U
#define GPIOI_PIN3                  3U
#define GPIOI_PIN4                  4U
#define GPIOI_PIN5                  5U
#define GPIOI_PIN6                  6U
#define GPIOI_PIN7                  7U
#define GPIOI_PIN8                  8U
#define GPIOI_PIN9                  9U
#define GPIOI_PIN10                 10U
#define GPIOI_PIN11                 11U
#define GPIOI_PIN12                 12U
#define GPIOI_PIN13                 13U
#define GPIOI_PIN14                 14U
#define GPIOI_PIN15                 15U

#define GPIOJ_PIN0                  0U
#define GPIOJ_PIN1                  1U
#define GPIOJ_PIN2                  2U
#define GPIOJ_PIN3                  3U
#define GPIOJ_PIN4                  4U
#define GPIOJ_PIN5                  5U
#define GPIOJ_PIN6                  6U
#define GPIOJ_PIN7                  7U
#define GPIOJ_PIN8                  8U
#define GPIOJ_PIN9                  9U
#define GPIOJ_PIN10                 10U
#define GPIOJ_PIN11                 11U
#define GPIOJ_PIN12                 12U
#define GPIOJ_PIN13                 13U
#define GPIOJ_PIN14                 14U
#define GPIOJ_PIN15                 15U

#define GPIOK_PIN0                  0U
#define GPIOK_PIN1                  1U
#define GPIOK_PIN2                  2U
#define GPIOK_PIN3                  3U
#define GPIOK_PIN4                  4U
#define GPIOK_PIN5                  5U
#define GPIOK_PIN6                  6U
#define GPIOK_PIN7                  7U
#define GPIOK_PIN8                  8U
#define GPIOK_PIN9                  9U
#define GPIOK_PIN10                 10U
#define GPIOK_PIN11                 11U
#define GPIOK_PIN12                 12U
#define GPIOK_PIN13                 13U
#define GPIOK_PIN14                 14U
#define GPIOK_PIN15                 15U

/*
 * IO lines assignments.
 */

// IO
#define LINE_IO_TXD                 PAL_LINE(GPIOB, 10U)
#define LINE_IO_LED1                PAL_LINE(GPIOB, 13U)
#define LINE_IO_LED2                PAL_LINE(GPIOC, 9U)

// GPS
#define LINE_GPS_EN                 PAL_LINE(GPIOC, 11U)
#define LINE_GPS_RESET              PAL_LINE(GPIOC, 13U)
#define LINE_GPS_TXD                PAL_LINE(GPIOB, 9U)
#define LINE_GPS_RXD                PAL_LINE(GPIOB, 8U)

// I2C
#define LINE_I2C_SCL                PAL_LINE(GPIOB, 6U)
#define LINE_I2C_SDA                PAL_LINE(GPIOB, 7U)

// SPI
#define LINE_SPI_SCK                PAL_LINE(GPIOB, 3U)
#define LINE_SPI_MISO               PAL_LINE(GPIOB, 4U)
#define LINE_SPI_MOSI               PAL_LINE(GPIOB, 5U)

// Camera pins
#define LINE_CAM_XCLK               PAL_LINE(GPIOA, 8U)
#define LINE_CAM_PCLK               PAL_LINE(GPIOC, 6U)
#define LINE_CAM_HREF               PAL_LINE(GPIOC, 2U)
#define LINE_CAM_VSYNC              PAL_LINE(GPIOC, 1U)
#define LINE_CAM_D2                 PAL_LINE(GPIOA, 0U)
#define LINE_CAM_D3                 PAL_LINE(GPIOA, 1U)
#define LINE_CAM_D4                 PAL_LINE(GPIOA, 2U)
#define LINE_CAM_D5                 PAL_LINE(GPIOA, 3U)
#define LINE_CAM_D6                 PAL_LINE(GPIOA, 4U)
#define LINE_CAM_D7                 PAL_LINE(GPIOA, 5U)
#define LINE_CAM_D8                 PAL_LINE(GPIOA, 6U)
#define LINE_CAM_D9                 PAL_LINE(GPIOA, 7U)
#define LINE_CAM_EN                 PAL_LINE(GPIOB, 14U)
#define LINE_CAM_RESET              PAL_LINE(GPIOC, 5U)

// Radio pins
#define LINE_RADIO_CS               PAL_LINE(GPIOD, 2U)
#define LINE_RADIO_SDN              PAL_LINE(GPIOA, 15U)
#define LINE_RADIO_GPIO             PAL_LINE(GPIOC, 12U)

// ADC
#define LINE_ADC_VSOL               PAL_LINE(GPIOB, 1U)
#define LINE_ADC_VBAT               PAL_LINE(GPIOC, 3U)
#define LINE_ADC_VUSB               PAL_LINE(GPIOC, 4U)

// USB
#define LINE_USB_ID                 PAL_LINE(GPIOA, 10U)
#define LINE_USB_VUSB               PAL_LINE(GPIOA, 9U)
#define LINE_USB_DM                 PAL_LINE(GPIOA, 11U)
#define LINE_USB_DP                 PAL_LINE(GPIOA, 12U)

// Misc
#define LINE_VBOOST                 PAL_LINE(GPIOC, 8U)
#define LINE_OSC_EN                 PAL_LINE(GPIOC, 10U)
#define LINE_SOL_SHORT_EN           PAL_LINE(GPIOC, 7U)



/*
 * I/O ports initial setup, this configuration is established soon after reset
 * in the initialization code.
 * Please refer to the STM32 Reference Manual for details.
 */
#define PIN_MODE_INPUT(n)           (0U << ((n) * 2U))
#define PIN_MODE_OUTPUT(n)          (1U << ((n) * 2U))
#define PIN_MODE_ALTERNATE(n)       (2U << ((n) * 2U))
#define PIN_MODE_ANALOG(n)          (3U << ((n) * 2U))
#define PIN_ODR_LOW(n)              (0U << (n))
#define PIN_ODR_HIGH(n)             (1U << (n))
#define PIN_OTYPE_PUSHPULL(n)       (0U << (n))
#define PIN_OTYPE_OPENDRAIN(n)      (1U << (n))
#define PIN_OSPEED_VERYLOW(n)       (0U << ((n) * 2U))
#define PIN_OSPEED_LOW(n)           (1U << ((n) * 2U))
#define PIN_OSPEED_MEDIUM(n)        (2U << ((n) * 2U))
#define PIN_OSPEED_HIGH(n)          (3U << ((n) * 2U))
#define PIN_PUPDR_FLOATING(n)       (0U << ((n) * 2U))
#define PIN_PUPDR_PULLUP(n)         (1U << ((n) * 2U))
#define PIN_PUPDR_PULLDOWN(n)       (2U << ((n) * 2U))
#define PIN_AFIO_AF(n, v)           ((v) << (((n) % 8U) * 4U))

/*
 * GPIOA setup:
 *
 * PA0  - ZIO_D32 TIM2_CH1          (input pullup).
 * PA1  - PIN1                      (input pullup).
 * PA2  - ZIO_A8 ADC1_IN2           (input pullup).
 * PA3  - ARD_A0 ADC1_IN3           (input pullup).
 * PA4  - ZIO_D24 SPI3_NSS          (input pullup).
 * PA5  - ARD_D13 SPI1_SCK          (input pullup).
 * PA6  - ARD_D12 SPI1_MISO         (input pullup).
 * PA7  - ARD_D11 SPI1_MOSI ZIO_D71 (input pullup).
 * PA8  - USB_SOF                   (alternate 10).
 * PA9  - USB_VBUS                  (analog).
 * PA10 - USB_ID                    (alternate 10).
 * PA11 - USB_DM                    (alternate 10).
 * PA12 - USB_DP                    (alternate 10).
 * PA13 - SWDIO                     (alternate 0).
 * PA14 - SWCLK                     (alternate 0).
 * PA15 - ZIO_D20 I2S3_WS           (alternate 6).
 */
#define VAL_GPIOA_MODER             (PIN_MODE_INPUT(GPIOA_PIN0) |           \
                                     PIN_MODE_INPUT(GPIOA_PIN1) |           \
                                     PIN_MODE_INPUT(GPIOA_PIN2) |           \
                                     PIN_MODE_INPUT(GPIOA_PIN3) |           \
                                     PIN_MODE_INPUT(GPIOA_PIN4) |           \
                                     PIN_MODE_INPUT(GPIOA_PIN5) |           \
                                     PIN_MODE_INPUT(GPIOA_PIN6) |           \
                                     PIN_MODE_INPUT(GPIOA_PIN7) |           \
                                     PIN_MODE_INPUT(GPIOA_PIN8) |           \
                                     PIN_MODE_INPUT(GPIOA_USB_VBUS) |       \
                                     PIN_MODE_ALTERNATE(GPIOA_USB_ID) |     \
                                     PIN_MODE_ALTERNATE(GPIOA_USB_DM) |     \
                                     PIN_MODE_ALTERNATE(GPIOA_USB_DP) |     \
                                     PIN_MODE_ALTERNATE(GPIOA_SWDIO) |      \
                                     PIN_MODE_ALTERNATE(GPIOA_SWCLK) |      \
                                     PIN_MODE_INPUT(GPIOA_PIN15))
#define VAL_GPIOA_OTYPER            (PIN_OTYPE_PUSHPULL(GPIOA_PIN0) |       \
                                     PIN_OTYPE_PUSHPULL(GPIOA_PIN1) |       \
                                     PIN_OTYPE_PUSHPULL(GPIOA_PIN2) |       \
                                     PIN_OTYPE_PUSHPULL(GPIOA_PIN3) |       \
                                     PIN_OTYPE_PUSHPULL(GPIOA_PIN4) |       \
                                     PIN_OTYPE_PUSHPULL(GPIOA_PIN5) |       \
                                     PIN_OTYPE_PUSHPULL(GPIOA_PIN6) |       \
                                     PIN_OTYPE_PUSHPULL(GPIOA_PIN7) |       \
                                     PIN_OTYPE_PUSHPULL(GPIOA_PIN8) |       \
                                     PIN_OTYPE_PUSHPULL(GPIOA_USB_VBUS) |       \
                                     PIN_OTYPE_PUSHPULL(GPIOA_USB_ID) |      \
                                     PIN_OTYPE_PUSHPULL(GPIOA_USB_DM) |      \
                                     PIN_OTYPE_PUSHPULL(GPIOA_USB_DP) |      \
                                     PIN_OTYPE_PUSHPULL(GPIOA_SWDIO) |      \
                                     PIN_OTYPE_PUSHPULL(GPIOA_SWCLK) |      \
                                     PIN_OTYPE_PUSHPULL(GPIOA_PIN15))
#define VAL_GPIOA_OSPEEDR           (PIN_OSPEED_VERYLOW(GPIOA_PIN0) |       \
                                     PIN_OSPEED_VERYLOW(GPIOA_PIN1) |       \
                                     PIN_OSPEED_VERYLOW(GPIOA_PIN2) |       \
                                     PIN_OSPEED_VERYLOW(GPIOA_PIN3) |       \
                                     PIN_OSPEED_VERYLOW(GPIOA_PIN4) |       \
                                     PIN_OSPEED_VERYLOW(GPIOA_PIN5) |       \
                                     PIN_OSPEED_VERYLOW(GPIOA_PIN6) |       \
                                     PIN_OSPEED_VERYLOW(GPIOA_PIN7) |       \
                                     PIN_OSPEED_VERYLOW(GPIOA_PIN8) |       \
                                     PIN_OSPEED_HIGH(GPIOA_USB_VBUS) |       \
                                     PIN_OSPEED_HIGH(GPIOA_USB_ID) |      \
                                     PIN_OSPEED_HIGH(GPIOA_USB_DM) |      \
                                     PIN_OSPEED_HIGH(GPIOA_USB_DP) |      \
                                     PIN_OSPEED_HIGH(GPIOA_SWDIO) |         \
                                     PIN_OSPEED_HIGH(GPIOA_SWCLK) |         \
                                     PIN_OSPEED_VERYLOW(GPIOA_PIN15))
#define VAL_GPIOA_PUPDR             (PIN_PUPDR_PULLDOWN(GPIOA_PIN0) |       \
                                     PIN_PUPDR_PULLDOWN(GPIOA_PIN1) |       \
                                     PIN_PUPDR_PULLDOWN(GPIOA_PIN2) |       \
                                     PIN_PUPDR_PULLDOWN(GPIOA_PIN3) |       \
                                     PIN_PUPDR_PULLDOWN(GPIOA_PIN4) |       \
                                     PIN_PUPDR_PULLDOWN(GPIOA_PIN5) |       \
                                     PIN_PUPDR_PULLDOWN(GPIOA_PIN6) |       \
                                     PIN_PUPDR_PULLDOWN(GPIOA_PIN7) |       \
                                     PIN_PUPDR_PULLDOWN(GPIOA_PIN8) |       \
                                     PIN_PUPDR_FLOATING(GPIOA_USB_VBUS) |       \
                                     PIN_PUPDR_FLOATING(GPIOA_USB_ID) |      \
                                     PIN_PUPDR_FLOATING(GPIOA_USB_DM) |      \
                                     PIN_PUPDR_FLOATING(GPIOA_USB_DP) |      \
                                     PIN_PUPDR_FLOATING(GPIOA_SWDIO) |      \
                                     PIN_PUPDR_FLOATING(GPIOA_SWCLK) |      \
                                     PIN_PUPDR_PULLDOWN(GPIOA_PIN15))
#define VAL_GPIOA_ODR               (PIN_ODR_HIGH(GPIOA_PIN0) |             \
                                     PIN_ODR_HIGH(GPIOA_PIN1) |             \
                                     PIN_ODR_HIGH(GPIOA_PIN2) |             \
                                     PIN_ODR_HIGH(GPIOA_PIN3) |             \
                                     PIN_ODR_HIGH(GPIOA_PIN4) |             \
                                     PIN_ODR_HIGH(GPIOA_PIN5) |             \
                                     PIN_ODR_HIGH(GPIOA_PIN6) |             \
                                     PIN_ODR_HIGH(GPIOA_PIN7) |             \
                                     PIN_ODR_HIGH(GPIOA_PIN8) |             \
                                     PIN_ODR_HIGH(GPIOA_USB_VBUS) |             \
                                     PIN_ODR_HIGH(GPIOA_USB_ID) |            \
                                     PIN_ODR_HIGH(GPIOA_USB_DM) |            \
                                     PIN_ODR_HIGH(GPIOA_USB_DP) |            \
                                     PIN_ODR_HIGH(GPIOA_SWDIO) |            \
                                     PIN_ODR_HIGH(GPIOA_SWCLK) |            \
                                     PIN_ODR_HIGH(GPIOA_PIN15))
#define VAL_GPIOA_AFRL              (PIN_AFIO_AF(GPIOA_PIN0, 0) |           \
                                     PIN_AFIO_AF(GPIOA_PIN1, 0) |           \
                                     PIN_AFIO_AF(GPIOA_PIN2, 0) |           \
                                     PIN_AFIO_AF(GPIOA_PIN3, 0) |           \
                                     PIN_AFIO_AF(GPIOA_PIN4, 0) |           \
                                     PIN_AFIO_AF(GPIOA_PIN5, 0) |           \
                                     PIN_AFIO_AF(GPIOA_PIN6, 0) |           \
                                     PIN_AFIO_AF(GPIOA_PIN7, 0))
#define VAL_GPIOA_AFRH              (PIN_AFIO_AF(GPIOA_PIN8, 0) |           \
                                     PIN_AFIO_AF(GPIOA_USB_VBUS, 0) |           \
                                     PIN_AFIO_AF(GPIOA_USB_ID, 10) |          \
                                     PIN_AFIO_AF(GPIOA_USB_DM, 10) |          \
                                     PIN_AFIO_AF(GPIOA_USB_DP, 10) |          \
                                     PIN_AFIO_AF(GPIOA_SWDIO, 0) |          \
                                     PIN_AFIO_AF(GPIOA_SWCLK, 0) |          \
                                     PIN_AFIO_AF(GPIOA_PIN15, 0))

/*
 * GPIOB setup:
 *
 * PB0  - ZIO_D33 TIM3_CH3 LED1     (output pushpull maximum).
 * PB1  - ZIO_A6 ADC1_IN9           (input pullup).
 * PB2  - ZIO_D27 QUADSPI_CLK       (input pullup).
 * PB3  - ZIO_D23 I2S3_CK           (input pullup).
 * PB4  - ZIO_D25 SPI3_MISO         (input pullup).
 * PB5  - ZIO_D22 I2S3_SD           (input pullup).
 * PB6  - ZIO_D26 QUADSPI_BK1_NCS   (input pullup).
 * PB7  - LED2                      (output pushpull maximum).
 * PB8  - ARD_D15 I2C1_SCL          (input pullup).
 * PB9  - ARD_D14 I2C1_SDA          (input pullup).
 * PB10 - ZIO_D36 TIM2_CH3          (input pullup).
 * PB11 - ZIO_D35 TIM2_CH4          (input pullup).
 * PB12 - ZIO_D19 I2S2_WS           (input pullup).
 * PB13 - ZIO_D18 I2S2_CK           (input pullup).
 * PB14 - LED3                      (output pushpull maximum).
 * PB15 - ZIO_D17 I2S2_SD           (input pullup).
 */
#define VAL_GPIOB_MODER             (PIN_MODE_INPUT(GPIOB_PIN0) |           \
                                     PIN_MODE_INPUT(GPIOB_PIN1) |           \
                                     PIN_MODE_INPUT(GPIOB_PIN2) |           \
                                     PIN_MODE_INPUT(GPIOB_PIN3) |           \
                                     PIN_MODE_INPUT(GPIOB_PIN4) |           \
                                     PIN_MODE_INPUT(GPIOB_PIN5) |           \
                                     PIN_MODE_INPUT(GPIOB_PIN6) |           \
                                     PIN_MODE_INPUT(GPIOB_PIN7) |           \
                                     PIN_MODE_INPUT(GPIOB_PIN8) |           \
                                     PIN_MODE_INPUT(GPIOB_PIN9) |           \
                                     PIN_MODE_INPUT(GPIOB_PIN10) |          \
                                     PIN_MODE_INPUT(GPIOB_PIN11) |          \
                                     PIN_MODE_INPUT(GPIOB_PIN12) |          \
                                     PIN_MODE_INPUT(GPIOB_PIN13) |          \
                                     PIN_MODE_INPUT(GPIOB_PIN14) |          \
                                     PIN_MODE_INPUT(GPIOB_PIN15))
#define VAL_GPIOB_OTYPER            (PIN_OTYPE_PUSHPULL(GPIOB_PIN0) |       \
                                     PIN_OTYPE_PUSHPULL(GPIOB_PIN1) |       \
                                     PIN_OTYPE_PUSHPULL(GPIOB_PIN2) |       \
                                     PIN_OTYPE_PUSHPULL(GPIOB_PIN3) |       \
                                     PIN_OTYPE_PUSHPULL(GPIOB_PIN4) |       \
                                     PIN_OTYPE_PUSHPULL(GPIOB_PIN5) |       \
                                     PIN_OTYPE_PUSHPULL(GPIOB_PIN6) |       \
                                     PIN_OTYPE_PUSHPULL(GPIOB_PIN7) |       \
                                     PIN_OTYPE_PUSHPULL(GPIOB_PIN8) |       \
                                     PIN_OTYPE_PUSHPULL(GPIOB_PIN9) |       \
                                     PIN_OTYPE_PUSHPULL(GPIOB_PIN10) |      \
                                     PIN_OTYPE_PUSHPULL(GPIOB_PIN11) |      \
                                     PIN_OTYPE_PUSHPULL(GPIOB_PIN12) |      \
                                     PIN_OTYPE_PUSHPULL(GPIOB_PIN13) |      \
                                     PIN_OTYPE_PUSHPULL(GPIOB_PIN14) |      \
                                     PIN_OTYPE_PUSHPULL(GPIOB_PIN15))
#define VAL_GPIOB_OSPEEDR           (PIN_OSPEED_VERYLOW(GPIOB_PIN0) |       \
                                     PIN_OSPEED_VERYLOW(GPIOB_PIN1) |       \
                                     PIN_OSPEED_VERYLOW(GPIOB_PIN2) |       \
                                     PIN_OSPEED_VERYLOW(GPIOB_PIN3) |       \
                                     PIN_OSPEED_VERYLOW(GPIOB_PIN4) |       \
                                     PIN_OSPEED_VERYLOW(GPIOB_PIN5) |       \
                                     PIN_OSPEED_VERYLOW(GPIOB_PIN6) |       \
                                     PIN_OSPEED_VERYLOW(GPIOB_PIN7) |       \
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
                                     PIN_AFIO_AF(GPIOB_PIN13, 0) |          \
                                     PIN_AFIO_AF(GPIOB_PIN14, 0) |          \
                                     PIN_AFIO_AF(GPIOB_PIN15, 0))

/*
 * GPIOC setup:
 *
 * PC0  - ARD_A1 ADC1_IN10          (input pullup).
 * PC1  - ARD_A3 ADC1_IN11          (input pullup).
 * PC2  - ZIO_A7 ADC1_IN12          (input pullup).
 * PC3  - ARD_A2 ADC1_IN13          (input pullup).
 * PC4  - ARD_A4 ADC1_IN14          (input pullup).
 * PC5  - ARD_A5 ADC1_IN15          (input pullup).
 * PC6  - ZIO_D16 I2S2_MCK          (input pullup).
 * PC7  - ZIO_D21 I2S3_MCK          (input pullup).
 * PC8  - ZIO_D43 SDMMC_D0          (input pullup).
 * PC9  - ZIO_D44 SDMMC_D1          (input pullup).
 * PC10 - ZIO_D45 SDMMC_D2          (input pullup).
 * PC11 - ZIO_D46 SDMMC_D3          (input pullup).
 * PC12 - ZIO_D47 SDMMC_CK          (input pullup).
 * PC13 - BUTTON                    (input floating).
 * PC14 - OSC32_IN                  (input floating).
 * PC15 - OSC32_OUT                 (input floating).
 */
#define VAL_GPIOC_MODER             (PIN_MODE_INPUT(GPIOC_PIN0) |           \
                                     PIN_MODE_INPUT(GPIOC_PIN1) |           \
                                     PIN_MODE_INPUT(GPIOC_PIN2) |           \
                                     PIN_MODE_INPUT(GPIOC_PIN3) |           \
                                     PIN_MODE_INPUT(GPIOC_PIN4) |           \
                                     PIN_MODE_INPUT(GPIOC_PIN5) |           \
                                     PIN_MODE_INPUT(GPIOC_PIN6) |           \
                                     PIN_MODE_INPUT(GPIOC_PIN7) |           \
                                     PIN_MODE_INPUT(GPIOC_PIN8) |           \
                                     PIN_MODE_INPUT(GPIOC_PIN9) |           \
                                     PIN_MODE_INPUT(GPIOC_PIN10) |          \
                                     PIN_MODE_INPUT(GPIOC_PIN11) |          \
                                     PIN_MODE_INPUT(GPIOC_PIN12) |          \
                                     PIN_MODE_INPUT(GPIOC_PIN13) |          \
                                     PIN_MODE_INPUT(GPIOC_OSC32_IN) |       \
                                     PIN_MODE_INPUT(GPIOC_OSC32_OUT))
#define VAL_GPIOC_OTYPER            (PIN_OTYPE_PUSHPULL(GPIOC_PIN0) |       \
                                     PIN_OTYPE_PUSHPULL(GPIOC_PIN1) |       \
                                     PIN_OTYPE_PUSHPULL(GPIOC_PIN2) |       \
                                     PIN_OTYPE_PUSHPULL(GPIOC_PIN3) |       \
                                     PIN_OTYPE_PUSHPULL(GPIOC_PIN4) |       \
                                     PIN_OTYPE_PUSHPULL(GPIOC_PIN5) |       \
                                     PIN_OTYPE_PUSHPULL(GPIOC_PIN6) |       \
                                     PIN_OTYPE_PUSHPULL(GPIOC_PIN7) |       \
                                     PIN_OTYPE_PUSHPULL(GPIOC_PIN8) |       \
                                     PIN_OTYPE_PUSHPULL(GPIOC_PIN9) |       \
                                     PIN_OTYPE_PUSHPULL(GPIOC_PIN10) |      \
                                     PIN_OTYPE_PUSHPULL(GPIOC_PIN11) |      \
                                     PIN_OTYPE_PUSHPULL(GPIOC_PIN12) |      \
                                     PIN_OTYPE_PUSHPULL(GPIOC_PIN13) |      \
                                     PIN_OTYPE_PUSHPULL(GPIOC_OSC32_IN) |   \
                                     PIN_OTYPE_PUSHPULL(GPIOC_OSC32_OUT))
#define VAL_GPIOC_OSPEEDR           (PIN_OSPEED_VERYLOW(GPIOC_PIN0) |       \
                                     PIN_OSPEED_VERYLOW(GPIOC_PIN1) |       \
                                     PIN_OSPEED_VERYLOW(GPIOC_PIN2) |       \
                                     PIN_OSPEED_VERYLOW(GPIOC_PIN3) |       \
                                     PIN_OSPEED_VERYLOW(GPIOC_PIN4) |       \
                                     PIN_OSPEED_VERYLOW(GPIOC_PIN5) |       \
                                     PIN_OSPEED_VERYLOW(GPIOC_PIN6) |       \
                                     PIN_OSPEED_VERYLOW(GPIOC_PIN7) |       \
                                     PIN_OSPEED_VERYLOW(GPIOC_PIN8) |       \
                                     PIN_OSPEED_VERYLOW(GPIOC_PIN9) |       \
                                     PIN_OSPEED_VERYLOW(GPIOC_PIN10) |      \
                                     PIN_OSPEED_VERYLOW(GPIOC_PIN11) |      \
                                     PIN_OSPEED_VERYLOW(GPIOC_PIN12) |      \
                                     PIN_OSPEED_VERYLOW(GPIOC_PIN13) |      \
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
                                     PIN_AFIO_AF(GPIOC_PIN13, 0) |          \
                                     PIN_AFIO_AF(GPIOC_OSC32_IN, 0) |       \
                                     PIN_AFIO_AF(GPIOC_OSC32_OUT, 0))

/*
 * GPIOD setup:
 *
 * PD0  - ZIO_D67 CAN1_RX           (input pullup).
 * PD1  - ZIO_D66 CAN1_TX           (input pullup).
 * PD2  - ZIO_D48 SDMMC_CMD         (input pullup).
 * PD3  - ZIO_D55 USART2_CTS        (input pullup).
 * PD4  - ZIO_D54 USART2_RTS        (input pullup).
 * PD5  - ZIO_D53 USART2_TX         (input pullup).
 * PD6  - ZIO_D52 USART2_RX         (input pullup).
 * PD7  - ZIO_D51 USART2_SCLK       (input pullup).
 * PD8  - USART3_RX STLK_RX         (alternate 7).
 * PD9  - USART3_TX STLK_TX         (alternate 7).
 * PD10 - PIN10                     (input pullup).
 * PD11 - ZIO_D30 QUADSPI_BK1_IO0   (input pullup).
 * PD12 - ZIO_D29 QUADSPI_BK1_IO1   (input pullup).
 * PD13 - ZIO_D28 QUADSPI_BK1_IO3   (input pullup).
 * PD14 - ARD_D10 SPI1_NSS          (input pullup).
 * PD15 - ARD_D9 TIM4_CH4           (input pullup).
 */
#define VAL_GPIOD_MODER             (PIN_MODE_INPUT(GPIOD_PIN0) |           \
                                     PIN_MODE_INPUT(GPIOD_PIN1) |           \
                                     PIN_MODE_INPUT(GPIOD_PIN2) |           \
                                     PIN_MODE_INPUT(GPIOD_PIN3) |           \
                                     PIN_MODE_INPUT(GPIOD_PIN4) |           \
                                     PIN_MODE_INPUT(GPIOD_PIN5) |           \
                                     PIN_MODE_INPUT(GPIOD_PIN6) |           \
                                     PIN_MODE_INPUT(GPIOD_PIN7) |           \
                                     PIN_MODE_INPUT(GPIOD_PIN8) |           \
                                     PIN_MODE_INPUT(GPIOD_PIN9) |           \
                                     PIN_MODE_INPUT(GPIOD_PIN10) |          \
                                     PIN_MODE_INPUT(GPIOD_PIN11) |          \
                                     PIN_MODE_INPUT(GPIOD_PIN12) |          \
                                     PIN_MODE_INPUT(GPIOD_PIN13) |          \
                                     PIN_MODE_INPUT(GPIOD_PIN14) |          \
                                     PIN_MODE_INPUT(GPIOD_PIN15))
#define VAL_GPIOD_OTYPER            (PIN_OTYPE_PUSHPULL(GPIOD_PIN0) |       \
                                     PIN_OTYPE_PUSHPULL(GPIOD_PIN1) |       \
                                     PIN_OTYPE_PUSHPULL(GPIOD_PIN2) |       \
                                     PIN_OTYPE_PUSHPULL(GPIOD_PIN3) |       \
                                     PIN_OTYPE_PUSHPULL(GPIOD_PIN4) |       \
                                     PIN_OTYPE_PUSHPULL(GPIOD_PIN5) |       \
                                     PIN_OTYPE_PUSHPULL(GPIOD_PIN6) |       \
                                     PIN_OTYPE_PUSHPULL(GPIOD_PIN7) |       \
                                     PIN_OTYPE_PUSHPULL(GPIOD_PIN8) |       \
                                     PIN_OTYPE_PUSHPULL(GPIOD_PIN9) |       \
                                     PIN_OTYPE_PUSHPULL(GPIOD_PIN10) |      \
                                     PIN_OTYPE_PUSHPULL(GPIOD_PIN11) |      \
                                     PIN_OTYPE_PUSHPULL(GPIOD_PIN12) |      \
                                     PIN_OTYPE_PUSHPULL(GPIOD_PIN13) |      \
                                     PIN_OTYPE_PUSHPULL(GPIOD_PIN14) |      \
                                     PIN_OTYPE_PUSHPULL(GPIOD_PIN15))
#define VAL_GPIOD_OSPEEDR           (PIN_OSPEED_VERYLOW(GPIOD_PIN0) |       \
                                     PIN_OSPEED_VERYLOW(GPIOD_PIN1) |       \
                                     PIN_OSPEED_VERYLOW(GPIOD_PIN2) |       \
                                     PIN_OSPEED_VERYLOW(GPIOD_PIN3) |       \
                                     PIN_OSPEED_VERYLOW(GPIOD_PIN4) |       \
                                     PIN_OSPEED_VERYLOW(GPIOD_PIN5) |       \
                                     PIN_OSPEED_VERYLOW(GPIOD_PIN6) |       \
                                     PIN_OSPEED_VERYLOW(GPIOD_PIN7) |       \
                                     PIN_OSPEED_VERYLOW(GPIOD_PIN8) |       \
                                     PIN_OSPEED_VERYLOW(GPIOD_PIN9) |       \
                                     PIN_OSPEED_VERYLOW(GPIOD_PIN10) |      \
                                     PIN_OSPEED_VERYLOW(GPIOD_PIN11) |      \
                                     PIN_OSPEED_VERYLOW(GPIOD_PIN12) |      \
                                     PIN_OSPEED_VERYLOW(GPIOD_PIN13) |      \
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
                                     PIN_AFIO_AF(GPIOD_PIN13, 0) |          \
                                     PIN_AFIO_AF(GPIOD_PIN14, 0) |          \
                                     PIN_AFIO_AF(GPIOD_PIN15, 0))

/*
 * GPIOE setup:
 *
 * PE0  - ZIO_D34 TIM4_ETR          (input pullup).
 * PE1  - PIN1                      (input pullup).
 * PE2  - ZIO_D31 ZIO_D56 QUADSPI_BK1_IO2(input pullup).
 * PE3  - ZIO_D60 SAI1_SD_B         (input pullup).
 * PE4  - ZIO_D57 SAI1_FS_A         (input pullup).
 * PE5  - ZIO_D58 SAI1_SCK_A        (input pullup).
 * PE6  - ZIO_D59 SAI1_SD_A         (input pullup).
 * PE7  - ZIO_D41 TIM1_ETR          (input pullup).
 * PE8  - ZIO_D42 TIM1_CH1N         (input pullup).
 * PE9  - ARD_D6 TIM1_CH1           (input pullup).
 * PE10 - ZIO_D40 TIM1_CH2N         (input pullup).
 * PE11 - ARD_D5 TIM1_CH2           (input pullup).
 * PE12 - ZIO_D39 TIM1_CH3N         (input pullup).
 * PE13 - ARD_D3 TIM1_CH3           (input pullup).
 * PE14 - ZIO_D38                   (input pullup).
 * PE15 - ZIO_D37 TIM1_BKIN1        (input pullup).
 */
#define VAL_GPIOE_MODER             (PIN_MODE_INPUT(GPIOE_PIN0) |           \
                                     PIN_MODE_INPUT(GPIOE_PIN1) |           \
                                     PIN_MODE_INPUT(GPIOE_PIN2) |           \
                                     PIN_MODE_INPUT(GPIOE_PIN3) |           \
                                     PIN_MODE_INPUT(GPIOE_PIN4) |           \
                                     PIN_MODE_INPUT(GPIOE_PIN5) |           \
                                     PIN_MODE_INPUT(GPIOE_PIN6) |           \
                                     PIN_MODE_INPUT(GPIOE_PIN7) |           \
                                     PIN_MODE_INPUT(GPIOE_PIN8) |           \
                                     PIN_MODE_INPUT(GPIOE_PIN9) |           \
                                     PIN_MODE_INPUT(GPIOE_PIN10) |          \
                                     PIN_MODE_INPUT(GPIOE_PIN11) |          \
                                     PIN_MODE_INPUT(GPIOE_PIN12) |          \
                                     PIN_MODE_INPUT(GPIOE_PIN13) |          \
                                     PIN_MODE_INPUT(GPIOE_PIN14) |          \
                                     PIN_MODE_INPUT(GPIOE_PIN15))
#define VAL_GPIOE_OTYPER            (PIN_OTYPE_PUSHPULL(GPIOE_PIN0) |       \
                                     PIN_OTYPE_PUSHPULL(GPIOE_PIN1) |       \
                                     PIN_OTYPE_PUSHPULL(GPIOE_PIN2) |       \
                                     PIN_OTYPE_PUSHPULL(GPIOE_PIN3) |       \
                                     PIN_OTYPE_PUSHPULL(GPIOE_PIN4) |       \
                                     PIN_OTYPE_PUSHPULL(GPIOE_PIN5) |       \
                                     PIN_OTYPE_PUSHPULL(GPIOE_PIN6) |       \
                                     PIN_OTYPE_PUSHPULL(GPIOE_PIN7) |       \
                                     PIN_OTYPE_PUSHPULL(GPIOE_PIN8) |       \
                                     PIN_OTYPE_PUSHPULL(GPIOE_PIN9) |       \
                                     PIN_OTYPE_PUSHPULL(GPIOE_PIN10) |      \
                                     PIN_OTYPE_PUSHPULL(GPIOE_PIN11) |      \
                                     PIN_OTYPE_PUSHPULL(GPIOE_PIN12) |      \
                                     PIN_OTYPE_PUSHPULL(GPIOE_PIN13) |      \
                                     PIN_OTYPE_PUSHPULL(GPIOE_PIN14) |      \
                                     PIN_OTYPE_PUSHPULL(GPIOE_PIN15))
#define VAL_GPIOE_OSPEEDR           (PIN_OSPEED_VERYLOW(GPIOE_PIN0) |       \
                                     PIN_OSPEED_VERYLOW(GPIOE_PIN1) |       \
                                     PIN_OSPEED_VERYLOW(GPIOE_PIN2) |       \
                                     PIN_OSPEED_VERYLOW(GPIOE_PIN3) |       \
                                     PIN_OSPEED_VERYLOW(GPIOE_PIN4) |       \
                                     PIN_OSPEED_VERYLOW(GPIOE_PIN5) |       \
                                     PIN_OSPEED_VERYLOW(GPIOE_PIN6) |       \
                                     PIN_OSPEED_VERYLOW(GPIOE_PIN7) |       \
                                     PIN_OSPEED_VERYLOW(GPIOE_PIN8) |       \
                                     PIN_OSPEED_VERYLOW(GPIOE_PIN9) |       \
                                     PIN_OSPEED_VERYLOW(GPIOE_PIN10) |      \
                                     PIN_OSPEED_VERYLOW(GPIOE_PIN11) |      \
                                     PIN_OSPEED_VERYLOW(GPIOE_PIN12) |      \
                                     PIN_OSPEED_VERYLOW(GPIOE_PIN13) |      \
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
                                     PIN_AFIO_AF(GPIOE_PIN13, 0) |          \
                                     PIN_AFIO_AF(GPIOE_PIN14, 0) |          \
                                     PIN_AFIO_AF(GPIOE_PIN15, 0))

/*
 * GPIOF setup:
 *
 * PF0  - ZIO_D68 I2C2_SDA          (input pullup).
 * PF1  - ZIO_D69 I2C2_SCL          (input pullup).
 * PF2  - ZIO_D70 I2C2_SMBA         (input pullup).
 * PF3  - PIN3                      (input pullup).
 * PF4  - PIN4                      (input pullup).
 * PF5  - PIN5                      (input pullup).
 * PF6  - PIN6                      (input pullup).
 * PF7  - ZIO_D62 SAI1_MCLK_B       (input pullup).
 * PF8  - ZIO_D61 SAI1_SCK_B        (input pullup).
 * PF9  - ZIO_D63 SAI1_FS_B         (input pullup).
 * PF10 - PIN10                     (input pullup).
 * PF11 - PIN11                     (input pullup).
 * PF12 - ARD_D8                    (input pullup).
 * PF13 - ARD_D7                    (input pullup).
 * PF14 - ARD_D4                    (input pullup).
 * PF15 - ARD_D2                    (input pullup).
 */
#define VAL_GPIOF_MODER             (PIN_MODE_INPUT(GPIOF_PIN0) |           \
                                     PIN_MODE_INPUT(GPIOF_PIN1) |           \
                                     PIN_MODE_INPUT(GPIOF_PIN2) |           \
                                     PIN_MODE_INPUT(GPIOF_PIN3) |           \
                                     PIN_MODE_INPUT(GPIOF_PIN4) |           \
                                     PIN_MODE_INPUT(GPIOF_PIN5) |           \
                                     PIN_MODE_INPUT(GPIOF_PIN6) |           \
                                     PIN_MODE_INPUT(GPIOF_PIN7) |           \
                                     PIN_MODE_INPUT(GPIOF_PIN8) |           \
                                     PIN_MODE_INPUT(GPIOF_PIN9) |           \
                                     PIN_MODE_INPUT(GPIOF_PIN10) |          \
                                     PIN_MODE_INPUT(GPIOF_PIN11) |          \
                                     PIN_MODE_INPUT(GPIOF_PIN12) |          \
                                     PIN_MODE_INPUT(GPIOF_PIN13) |          \
                                     PIN_MODE_INPUT(GPIOF_PIN14) |          \
                                     PIN_MODE_INPUT(GPIOF_PIN15))
#define VAL_GPIOF_OTYPER            (PIN_OTYPE_PUSHPULL(GPIOF_PIN0) |       \
                                     PIN_OTYPE_PUSHPULL(GPIOF_PIN1) |       \
                                     PIN_OTYPE_PUSHPULL(GPIOF_PIN2) |       \
                                     PIN_OTYPE_PUSHPULL(GPIOF_PIN3) |       \
                                     PIN_OTYPE_PUSHPULL(GPIOF_PIN4) |       \
                                     PIN_OTYPE_PUSHPULL(GPIOF_PIN5) |       \
                                     PIN_OTYPE_PUSHPULL(GPIOF_PIN6) |       \
                                     PIN_OTYPE_PUSHPULL(GPIOF_PIN7) |       \
                                     PIN_OTYPE_PUSHPULL(GPIOF_PIN8) |       \
                                     PIN_OTYPE_PUSHPULL(GPIOF_PIN9) |       \
                                     PIN_OTYPE_PUSHPULL(GPIOF_PIN10) |      \
                                     PIN_OTYPE_PUSHPULL(GPIOF_PIN11) |      \
                                     PIN_OTYPE_PUSHPULL(GPIOF_PIN12) |      \
                                     PIN_OTYPE_PUSHPULL(GPIOF_PIN13) |      \
                                     PIN_OTYPE_PUSHPULL(GPIOF_PIN14) |      \
                                     PIN_OTYPE_PUSHPULL(GPIOF_PIN15))
#define VAL_GPIOF_OSPEEDR           (PIN_OSPEED_VERYLOW(GPIOF_PIN0) |       \
                                     PIN_OSPEED_VERYLOW(GPIOF_PIN1) |       \
                                     PIN_OSPEED_VERYLOW(GPIOF_PIN2) |       \
                                     PIN_OSPEED_VERYLOW(GPIOF_PIN3) |       \
                                     PIN_OSPEED_VERYLOW(GPIOF_PIN4) |       \
                                     PIN_OSPEED_VERYLOW(GPIOF_PIN5) |       \
                                     PIN_OSPEED_VERYLOW(GPIOF_PIN6) |       \
                                     PIN_OSPEED_VERYLOW(GPIOF_PIN7) |       \
                                     PIN_OSPEED_VERYLOW(GPIOF_PIN8) |       \
                                     PIN_OSPEED_VERYLOW(GPIOF_PIN9) |       \
                                     PIN_OSPEED_VERYLOW(GPIOF_PIN10) |      \
                                     PIN_OSPEED_VERYLOW(GPIOF_PIN11) |      \
                                     PIN_OSPEED_VERYLOW(GPIOF_PIN12) |      \
                                     PIN_OSPEED_VERYLOW(GPIOF_PIN13) |      \
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
                                     PIN_AFIO_AF(GPIOF_PIN13, 0) |          \
                                     PIN_AFIO_AF(GPIOF_PIN14, 0) |          \
                                     PIN_AFIO_AF(GPIOF_PIN15, 0))

/*
 * GPIOG setup:
 *
 * PG0  - ZIO_D65                   (input pullup).
 * PG1  - ZIO_D64                   (input pullup).
 * PG2  - ZIO_D49                   (input pullup).
 * PG3  - ZIO_D50                   (input pullup).
 * PG4  - PIN4                      (input pullup).
 * PG5  - PIN5                      (input pullup).
 * PG6  - USB_GPIO_OUT              (output pushpull maximum).
 * PG7  - USB_GPIO_IN               (input pullup).
 * PG8  - PIN8                      (input pullup).
 * PG9  - ARD_D0 USART6_RX          (input pullup).
 * PG10 - PIN10                     (input pullup).
 * PG11 - PIN11                     (input pullup).
 * PG12 - PIN12                     (input pullup).
 * PG13 - PIN13                     (input pullup).
 * PG14 - ARD_D1 USART6_TX          (input pullup).
 * PG15 - PIN15                     (input pullup).
 */
#define VAL_GPIOG_MODER             (PIN_MODE_INPUT(GPIOG_PIN0) |           \
                                     PIN_MODE_INPUT(GPIOG_PIN1) |           \
                                     PIN_MODE_INPUT(GPIOG_PIN2) |           \
                                     PIN_MODE_INPUT(GPIOG_PIN3) |           \
                                     PIN_MODE_INPUT(GPIOG_PIN4) |           \
                                     PIN_MODE_INPUT(GPIOG_PIN5) |           \
                                     PIN_MODE_INPUT(GPIOG_PIN6) |           \
                                     PIN_MODE_INPUT(GPIOG_PIN7) |           \
                                     PIN_MODE_INPUT(GPIOG_PIN8) |           \
                                     PIN_MODE_INPUT(GPIOG_PIN9) |           \
                                     PIN_MODE_INPUT(GPIOG_PIN10) |          \
                                     PIN_MODE_INPUT(GPIOG_PIN11) |          \
                                     PIN_MODE_INPUT(GPIOG_PIN12) |          \
                                     PIN_MODE_INPUT(GPIOG_PIN13) |          \
                                     PIN_MODE_INPUT(GPIOG_PIN14) |          \
                                     PIN_MODE_INPUT(GPIOG_PIN15))
#define VAL_GPIOG_OTYPER            (PIN_OTYPE_PUSHPULL(GPIOG_PIN0) |       \
                                     PIN_OTYPE_PUSHPULL(GPIOG_PIN1) |       \
                                     PIN_OTYPE_PUSHPULL(GPIOG_PIN2) |       \
                                     PIN_OTYPE_PUSHPULL(GPIOG_PIN3) |       \
                                     PIN_OTYPE_PUSHPULL(GPIOG_PIN4) |       \
                                     PIN_OTYPE_PUSHPULL(GPIOG_PIN5) |       \
                                     PIN_OTYPE_PUSHPULL(GPIOG_PIN6) |       \
                                     PIN_OTYPE_PUSHPULL(GPIOG_PIN7) |       \
                                     PIN_OTYPE_PUSHPULL(GPIOG_PIN8) |       \
                                     PIN_OTYPE_PUSHPULL(GPIOG_PIN9) |       \
                                     PIN_OTYPE_PUSHPULL(GPIOG_PIN10) |      \
                                     PIN_OTYPE_PUSHPULL(GPIOG_PIN11) |      \
                                     PIN_OTYPE_PUSHPULL(GPIOG_PIN12) |      \
                                     PIN_OTYPE_PUSHPULL(GPIOG_PIN13) |      \
                                     PIN_OTYPE_PUSHPULL(GPIOG_PIN14) |      \
                                     PIN_OTYPE_PUSHPULL(GPIOG_PIN15))
#define VAL_GPIOG_OSPEEDR           (PIN_OSPEED_VERYLOW(GPIOG_PIN0) |       \
                                     PIN_OSPEED_VERYLOW(GPIOG_PIN1) |       \
                                     PIN_OSPEED_VERYLOW(GPIOG_PIN2) |       \
                                     PIN_OSPEED_VERYLOW(GPIOG_PIN3) |       \
                                     PIN_OSPEED_VERYLOW(GPIOG_PIN4) |       \
                                     PIN_OSPEED_VERYLOW(GPIOG_PIN5) |       \
                                     PIN_OSPEED_VERYLOW(GPIOG_PIN6) |       \
                                     PIN_OSPEED_VERYLOW(GPIOG_PIN7) |       \
                                     PIN_OSPEED_VERYLOW(GPIOG_PIN8) |       \
                                     PIN_OSPEED_VERYLOW(GPIOG_PIN9) |       \
                                     PIN_OSPEED_VERYLOW(GPIOG_PIN10) |      \
                                     PIN_OSPEED_VERYLOW(GPIOG_PIN11) |      \
                                     PIN_OSPEED_VERYLOW(GPIOG_PIN12) |      \
                                     PIN_OSPEED_VERYLOW(GPIOG_PIN13) |      \
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
                                     PIN_AFIO_AF(GPIOG_PIN13, 0) |          \
                                     PIN_AFIO_AF(GPIOG_PIN14, 0) |          \
                                     PIN_AFIO_AF(GPIOG_PIN15, 0))

/*
 * GPIOH setup:
 *
 * PH0  - OSC_IN                    (input floating).
 * PH1  - OSC_OUT                   (input floating).
 * PH2  - PIN2                      (input pullup).
 * PH3  - PIN3                      (input pullup).
 * PH4  - PIN4                      (input pullup).
 * PH5  - PIN5                      (input pullup).
 * PH6  - PIN6                      (input pullup).
 * PH7  - PIN7                      (input pullup).
 * PH8  - PIN8                      (input pullup).
 * PH9  - PIN9                      (input pullup).
 * PH10 - PIN10                     (input pullup).
 * PH11 - PIN11                     (input pullup).
 * PH12 - PIN12                     (input pullup).
 * PH13 - PIN13                     (input pullup).
 * PH14 - PIN14                     (input pullup).
 * PH15 - PIN15                     (input pullup).
 */
#define VAL_GPIOH_MODER             (PIN_MODE_INPUT(GPIOH_OSC_IN) |         \
                                     PIN_MODE_INPUT(GPIOH_OSC_OUT) |        \
                                     PIN_MODE_INPUT(GPIOH_PIN2) |           \
                                     PIN_MODE_INPUT(GPIOH_PIN3) |           \
                                     PIN_MODE_INPUT(GPIOH_PIN4) |           \
                                     PIN_MODE_INPUT(GPIOH_PIN5) |           \
                                     PIN_MODE_INPUT(GPIOH_PIN6) |           \
                                     PIN_MODE_INPUT(GPIOH_PIN7) |           \
                                     PIN_MODE_INPUT(GPIOH_PIN8) |           \
                                     PIN_MODE_INPUT(GPIOH_PIN9) |           \
                                     PIN_MODE_INPUT(GPIOH_PIN10) |          \
                                     PIN_MODE_INPUT(GPIOH_PIN11) |          \
                                     PIN_MODE_INPUT(GPIOH_PIN12) |          \
                                     PIN_MODE_INPUT(GPIOH_PIN13) |          \
                                     PIN_MODE_INPUT(GPIOH_PIN14) |          \
                                     PIN_MODE_INPUT(GPIOH_PIN15))
#define VAL_GPIOH_OTYPER            (PIN_OTYPE_PUSHPULL(GPIOH_OSC_IN) |     \
                                     PIN_OTYPE_PUSHPULL(GPIOH_OSC_OUT) |    \
                                     PIN_OTYPE_PUSHPULL(GPIOH_PIN2) |       \
                                     PIN_OTYPE_PUSHPULL(GPIOH_PIN3) |       \
                                     PIN_OTYPE_PUSHPULL(GPIOH_PIN4) |       \
                                     PIN_OTYPE_PUSHPULL(GPIOH_PIN5) |       \
                                     PIN_OTYPE_PUSHPULL(GPIOH_PIN6) |       \
                                     PIN_OTYPE_PUSHPULL(GPIOH_PIN7) |       \
                                     PIN_OTYPE_PUSHPULL(GPIOH_PIN8) |       \
                                     PIN_OTYPE_PUSHPULL(GPIOH_PIN9) |       \
                                     PIN_OTYPE_PUSHPULL(GPIOH_PIN10) |      \
                                     PIN_OTYPE_PUSHPULL(GPIOH_PIN11) |      \
                                     PIN_OTYPE_PUSHPULL(GPIOH_PIN12) |      \
                                     PIN_OTYPE_PUSHPULL(GPIOH_PIN13) |      \
                                     PIN_OTYPE_PUSHPULL(GPIOH_PIN14) |      \
                                     PIN_OTYPE_PUSHPULL(GPIOH_PIN15))
#define VAL_GPIOH_OSPEEDR           (PIN_OSPEED_HIGH(GPIOH_OSC_IN) |        \
                                     PIN_OSPEED_HIGH(GPIOH_OSC_OUT) |       \
                                     PIN_OSPEED_VERYLOW(GPIOH_PIN2) |       \
                                     PIN_OSPEED_VERYLOW(GPIOH_PIN3) |       \
                                     PIN_OSPEED_VERYLOW(GPIOH_PIN4) |       \
                                     PIN_OSPEED_VERYLOW(GPIOH_PIN5) |       \
                                     PIN_OSPEED_VERYLOW(GPIOH_PIN6) |       \
                                     PIN_OSPEED_VERYLOW(GPIOH_PIN7) |       \
                                     PIN_OSPEED_VERYLOW(GPIOH_PIN8) |       \
                                     PIN_OSPEED_VERYLOW(GPIOH_PIN9) |       \
                                     PIN_OSPEED_VERYLOW(GPIOH_PIN10) |      \
                                     PIN_OSPEED_VERYLOW(GPIOH_PIN11) |      \
                                     PIN_OSPEED_VERYLOW(GPIOH_PIN12) |      \
                                     PIN_OSPEED_VERYLOW(GPIOH_PIN13) |      \
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
                                     PIN_PUPDR_PULLDOWN(GPIOK_PIN14) |      \
                                     PIN_PUPDR_PULLDOWN(GPIOK_PIN15))
#define VAL_GPIOK_ODR               (PIN_ODR_HIGH(GPIOK_PIN0) |             \
                                     PIN_ODR_HIGH(GPIOK_PIN1) |             \
                                     PIN_ODR_HIGH(GPIOK_PIN2) |             \
                                     PIN_ODR_HIGH(GPIOK_PIN3) |             \
                                     PIN_ODR_HIGH(GPIOK_PIN4) |             \
                                     PIN_ODR_HIGH(GPIOK_PIN5) |             \
                                     PIN_ODR_HIGH(GPIOK_PIN6) |             \
                                     PIN_ODR_HIGH(GPIOK_PIN7) |             \
                                     PIN_ODR_HIGH(GPIOK_PIN8) |             \
                                     PIN_ODR_HIGH(GPIOK_PIN9) |             \
                                     PIN_ODR_HIGH(GPIOK_PIN10) |            \
                                     PIN_ODR_HIGH(GPIOK_PIN11) |            \
                                     PIN_ODR_HIGH(GPIOK_PIN12) |            \
                                     PIN_ODR_HIGH(GPIOK_PIN13) |            \
                                     PIN_ODR_HIGH(GPIOK_PIN14) |            \
                                     PIN_ODR_HIGH(GPIOK_PIN15))
#define VAL_GPIOK_AFRL              (PIN_AFIO_AF(GPIOK_PIN0, 0) |           \
                                     PIN_AFIO_AF(GPIOK_PIN1, 0) |           \
                                     PIN_AFIO_AF(GPIOK_PIN2, 0) |           \
                                     PIN_AFIO_AF(GPIOK_PIN3, 0) |           \
                                     PIN_AFIO_AF(GPIOK_PIN4, 0) |           \
                                     PIN_AFIO_AF(GPIOK_PIN5, 0) |           \
                                     PIN_AFIO_AF(GPIOK_PIN6, 0) |           \
                                     PIN_AFIO_AF(GPIOK_PIN7, 0))
#define VAL_GPIOK_AFRH              (PIN_AFIO_AF(GPIOK_PIN8, 0) |           \
                                     PIN_AFIO_AF(GPIOK_PIN9, 0) |           \
                                     PIN_AFIO_AF(GPIOK_PIN10, 0) |          \
                                     PIN_AFIO_AF(GPIOK_PIN11, 0) |          \
                                     PIN_AFIO_AF(GPIOK_PIN12, 0) |          \
                                     PIN_AFIO_AF(GPIOK_PIN13, 0) |          \
                                     PIN_AFIO_AF(GPIOK_PIN14, 0) |          \
                                     PIN_AFIO_AF(GPIOK_PIN15, 0))


#if !defined(_FROM_ASM_)
#ifdef __cplusplus
extern "C" {
#endif
  void boardInit(void);
#ifdef __cplusplus
}
#endif
#endif /* _FROM_ASM_ */

#endif /* _BOARD_H_ */
