DL7AD/pecanpico9/(commit log)

2017-05-22 Initial upload commit
    [pecanpico8-B.Cu.gbl, pecanpico8-B.Mask.gbs, pecanpico8-B.Paste.gbp, pecanpico8-B.SilkS.gbo, pecanpico8-Edge.Cuts.gm1, pecanpico8-F.Cu.gtl, pecanpico8-F.Mask.gts, pecanpico8-F.Paste.gtp]
2017-05-22 Wiggled parts around
    [pecanpico9.kicad_pcb, pecanpico9.sch]
2017-05-23 Connected VUSB correctly to PA9
    [pecanpico9.kicad_pcb, pecanpico9.sch]
2017-05-23 Moved wire around
    [pecanpico9.kicad_pcb]
2017-05-23 Wiggled traces around, created Gerber
    [pecanpico8-B.Cu.gbl, pecanpico8-B.Mask.gbs, pecanpico8-B.Paste.gbp, pecanpico8-B.SilkS.gbo, pecanpico8-Edge.Cuts.gm1, pecanpico8-F.Cu.gtl, pecanpico8-F.Mask.gts, pecanpico8-F.Paste.gtp]
2017-05-26 Added BOM and pos files
    [bom.ods]
2017-05-27 Updated BOM
    [bom.ods, pecanpico9.kicad_pcb, pecanpico9.sch]
2017-05-28 Added picture of Pecan Pico 9a
2017-05-30 Moved tracker related files
    [bom.ods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]
2017-05-30 Moved tracker related files 2
    [bom.ods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]
2017-05-30 Deleted KiCAD cache files
    [pecanpico9.sch]
2017-05-31 Updated decoder software Implemented stdin connection Implemented APRS-IS connection Implemented error handling at internet loss
    [decoder.py]
2017-06-12 Brought basic operation to work USB not working yet Only QVGA working Radio is working GPS is not working yet BME1720 and PAC1720 working
    [board.h, chconf.h, config.c, config.h, debug.h, halconf.h, helper.c, helper.h]
2017-06-15 Implemented "Line" driver Renamed ublox driver Removed unused files Fixed STM32 ADC driver (incorrect solar reading) Implemented Solar short current measurement Merged Cofigurationt types Lowered Cor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
    [board.h, config.c, config.h, debug.h, halconf.h, image.c]
2017-06-15 Fixed SOT-23 footprint (wrong numbering) Moved LEDs (so they are not too close to the very big inductor) Added Pulldown to GPS_EN
    [pecanpico9.kicad_pcb, pecanpico9.sch]
2017-06-15 Added time to print
2017-06-20 Added documentation in config Merged configuration types Made USB and 3V switch configureable Removed USB debugging temporarly Adjusted camera clocking Removed Si4464 power conversion function Implem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
    [board.h, config.c, config.h, debug.h, image.c, log.c, main.c]
2017-06-22 Fixed logging error Made camera sampling faster (reduced SYSCLK)
    [config.c, config.h, mcuconf.h, tracking.c, types.h]
2017-06-30 Implemented camera buffer overflow protection Moved definitions around Changed Isol (PAC1720) measurement implementation Reimplemented logging and log transmission Changed Sleep implementation
2017-07-01 Fixed read last log point from memory
    [tracking.c]
2017-07-01 Changed GPS switch decisions
2017-07-07 Implemented STM32F413 (instead of STM32F412)
2017-07-24 Implemented hardware camera driver
2017-07-26 Implemented shell, worked on camera driver (not working)
    [config.h, debug.c, debug.h, main.c, position.c, tracking.c, tracking.h]
2017-08-19 Try to fix buffer overflow crash
    [config.c, image.c, ov5640.c]
2017-08-19 Removed locking mechanism for I2C
2017-08-19 Revision of ov5640.c dma interrupt handling.
2017-08-20 Fixed DMA release error
    [si4464.c]
2017-08-21 Flipped PCLK polarity, added TIM8 patch file
    [image.c]
2017-08-21 Added JPEG validation filter, changed method of last packet detection
2017-08-21 Add DMA DBM as multi-buffer handling for OV5640
2017-08-22 Fixed DMA error, implemented image size detection
    [image.c, ov5640.c, types.h]
2017-08-22 Increased I2C speed
2017-08-22 Added DMA transaction size
2017-08-23 Add saving of DMA flags so TRACE can output specific errors. Add TRACE messages for DMA error conditions. Consolidate DMA error condition flags. Add clear for DMA transfer full interrupt. Tidy up som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
    [ov5640.c]
2017-08-27 Fixed radio kept swiched on When a picture was sent, the radio was kept switched on. The detection of the image EOI did not work for the packet transmission because the EOI detection returned the met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
    [image.c, ov5640.c, radio.c, radio.h, si4464.c, si4464.h]
2017-08-28 Adjusted clocks Flipped image in OV5640 driver Fixed spelling
    [config.c, config.h, mcuconf.h, ov5640.c, sleep.c, types.h]
2017-08-28 Fixed faulty image transmission, implemented server exception handling in decoder
    [config.c, config.h, decoder.py, ov5640.c]
2017-08-28 Removed duplicate GPS printout, added more debugging at PVT Polling
2017-08-30 Adjusted clocks for low power operation (camera fix no implemented yet)
    [config.c, config.h, image.c, mcuconf.h, ov5640.c, ov5640.h, radio.c]
2017-08-30 Finalized clockling (so far) for power savings. All dividers for all clocks are static except for HPRE. HPRE is dynamically changed between /1 and /8. It is usually set to /8. If the camera is captur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
    The clock change has a drastic effect of the power consumption.
    --------------------------------------------------
    Running at 1.8V
    Position packet transmission, APRS AFSK, one pac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
2017-09-01 Implemented RBAT (Battery impedance measurement) Removed ISOL Added LOWBATT message in APRS position packet
2017-09-02 Fixed redundant TX error, fixed keep-tx-state-after-transmission error
    [config.c, radio.c, si4464.c, si4464.h]
2017-09-03 Implemented group transmission, implemented camera init once
2017-09-05 Reimplemented Packet handler for 2GFSK Changed timer implementation for 2FSK Implemented concurrent transmission and packet encoding (not working yet) Wrote documentation for config.c Implemented gro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
    [chconf.h, config.c, config.h, image.c, mcuconf.h, ov5640.c, pac1720.c, pi2c.c]
2017-09-05 Added... OR of EVT bits, blocking of init of fifo thread until it finishes.
2017-09-06 Implemented grouped APRS packet transmission properly Fixed packet losses (incomplete)
    [image.c, log.c, ov5640.c, pac1720.c]
2017-09-06 Changed USB implementation
    [pecanpico9.sch]
2017-09-06 Use SPI3 instead of SPI1, fixed radio/camera mutex bug
    [image.c, mcuconf.h, si4464.c]
2017-09-07 Added special STM32F413 ChibiOS version
    [stm_spc56ec74a256s_spc56ec74_minimodule_debug_jtag.cfg, stm_xpc560b64_minimodule_debug_jtag.cfg, stm_xpc560b_spc560d40_minimodule_debug_jtag.cfg, stm_xpc560p_minimodule_40mhz_debug_jtag.cfg, stm_xpc563m64_minimodule_debug_jtag.cfg, stm_xpc564a_spc564a70_minimodule_debug_jtag.cfg, stm_xpc56el_minimodule_lockstep_debug_jtag.cfg]
2017-09-07 Added USB switch in config
2017-09-08 Removed OSC+ net and salvaging pin for Si4464 Changed a lot of STM32 connections
    [pecanpico9.kicad_pcb, pecanpico9.sch]
2017-09-10 Fixed bug: Image transmission over USB was only possible when debug on USB was activated Fixed bug: Image transmission over USB was only possible when no image module was activated Added feature: Pri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
    [config.c, debug.c, debug.h, image.c, image.h, main.c, ov5640.c, ov5640.h]
2017-09-11 - Merged dbgon and dbgoff command to debug - Fixed error in SOI-not-found flag in debug.c - Added camera-command command (for testing different camera options while watching the livestream) - Fixed t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
    [command.py, config.c, debug.c, debug.h, decoder2.py, empty.py, image.c]
2017-09-12 Fixed image id initialization error
    [tracking.c]
2017-09-13 Fixed syntax bug in OV5640 Implemented OV5640 configurations which work for sure without HREF (tested on PP7 with DCMI) Adjusted clocking for camera
    [config.c, mcuconf.h, ov5640.c, ov5640.h, pac1720.c, position.c]
2017-09-14 Reactivated DMA DBM
2017-09-15 Added connection of PCLK to PC6 so the PCLK is sampled directly from a timer which is capable of triggering the DMA. Before a LPTIM1/TIM1 cascade was used which lead to errors in the DMA transmission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
    [board.h, debug.c, mcuconf.h, ov5640.c, ov5640.h, pac1720.c, pi2c.c, pi2c.h]
2017-09-19 Added voltage change when using OV5640 Added I2C Lock around voltage change methods Implemented RBAT sleep methods Fixed I2C init problem, reordered initialization methods
    [ov5640.c, padc.c, sleep.c, threads.c, tracking.c]
2017-09-19 Implemented receiver detection correctly
    [decoder.py]
2017-09-23 Removed I2C 0R resistors, removed USB diodes, Added USB ID
    [pecanpico9.kicad_pcb, pecanpico9.sch]
2017-10-02 Reimplemented Base91 Changed message buffer implementation Removed error transmission Moved getFrequency implementation to radio.c
    [decoder.py, image.c, log.c, position.c, radio.c]
2017-10-07 Modified Base91 characters Modified APRS format of Image and Log packets Implemented image Added memory address to log command (Serial USB console) Added failsafe to ADC measurements (if PAC1720 fail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
    [base91.py, config.c, debug.c, decoder.py, image.c]
2017-10-08 Split image packets in half, fixed timezone bug
    [config.c, decoder.py, image.c, image.py, position.py]
2017-10-14 Removed STM32 based modulation and moved task to PH of Si4464 (so stable HSE is not needed for STM32 anymore which was needed for radio modulation) Fixed receiver value in decoder.py Limited data dis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
    [config.c, decoder.py, image.c, image.py, log.c, main.c, mcuconf.h]
2017-10-16 Implemented UART/I2C switch for GPS Implemented LOWBATT1 and LOWBATT2 Switch off camera at JPEG validation process Moved JPEG validation section Added GPS communication error message Changed Watchdog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
    [image.c, main.c, mcuconf.h, ov5640.c, ov5640.h, radio.c, si4464.c]
2017-10-31 Fixed uBlox I2C compile error
    [ublox.c, ublox.h]
2017-12-12 Fixed GPS communication error
    [ublox.c]
2017-12-14 Reverted post hardware changes to produced version There was the plan to create Pecan Pico 9b, but all those changes have been put into Pecan Pico 10a.
    [pecanpico9.kicad_pcb, pecanpico9.sch]
2018-01-09 Updated APRS protocols and much more - Removed secondary decoder - Updated image encoding at tracker firmware - Updated image encoding at decoder software - Implemented more sophisticated website - A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
    [base91.py, bme280.c, bme280.h, config.c, config.h]
2018-01-13 Fixed camera sampling bug
    [mcuconf.h, ov5640.c]
2018-08-06 Inverted power measurement
